Biological-Robotics-at-Tulsa/The-TU-Hand/Drawings/Fusion 360/submarine_tether_concept.PNG

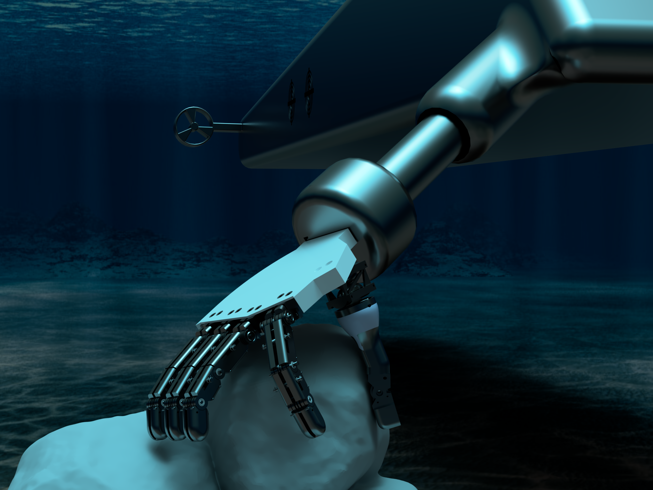
Drawings/Fusion 360/submarine_tether_concept.PNG
