Biological-Robotics-at-Tulsa/The-TU-Hand/Drawings/TU Hand 2019.JPG

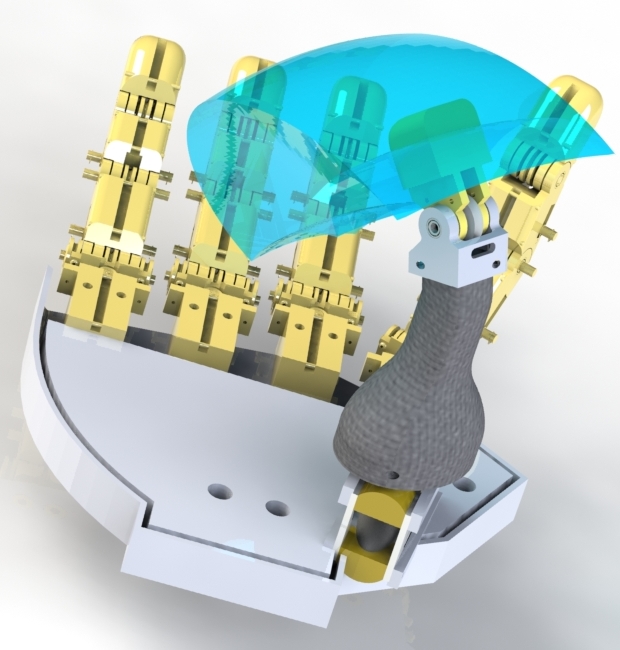
Drawings/TU Hand 2019.JPG
