Biological-Robotics-at-Tulsa/The-TU-Hand/README.md

# The-TU-Hand
A biologically inspired robotic hand for the evaluation of grasping and dexterity experiments.

## Contents
- Bill of Materials
- Drawings
- Firmware
- How-to Guides
