Biological-Robotics-at-Tulsa/The-TU-Hand/Drawings/Distal Phalanx for Pinky Finger - TU Hand 2019 v1.pdf

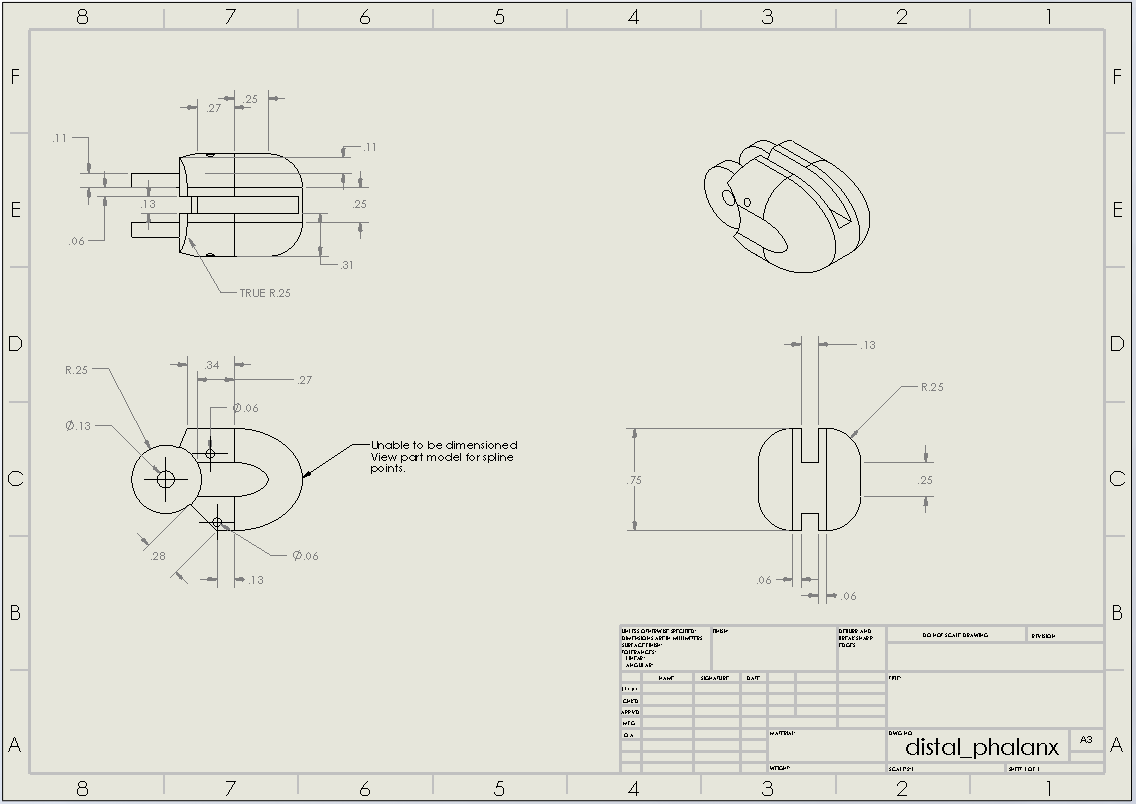
[picture p3: page 1]

All Dimensions in Inches .
