Biological-Robotics-at-Tulsa/The-TU-Hand/Drawings/NiPun - TU Hand 2019 v1.pdf

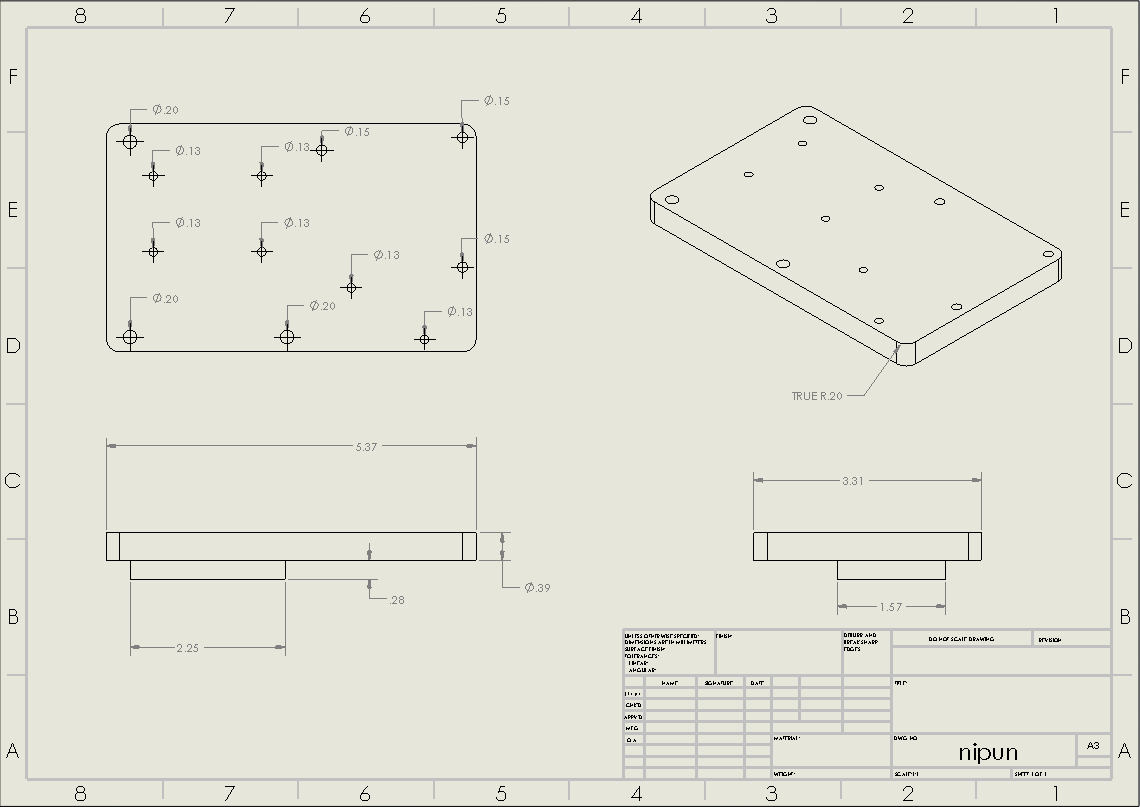
[picture p4: page 1]

All Dimensions in Inches .
