Biological-Robotics-at-Tulsa/The-TU-Hand/Drawings/TU Hand 2018.png

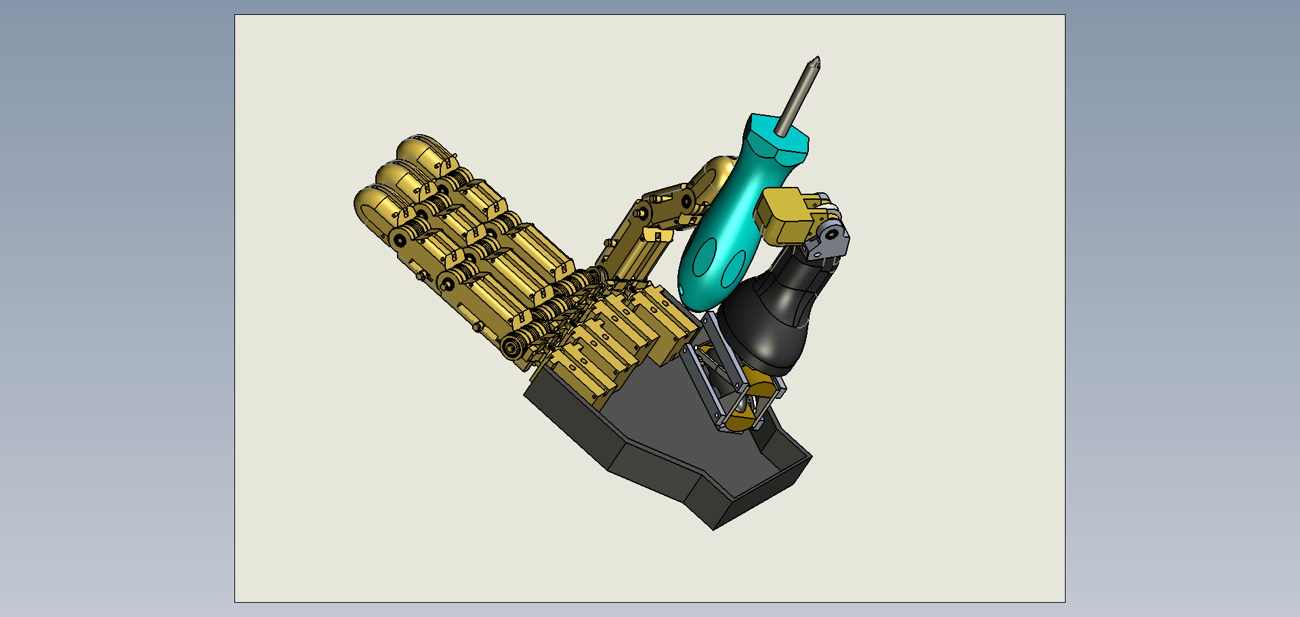
Drawings/TU Hand 2018.png
