Biological-Robotics-at-Tulsa/The-TU-Hand/Drawings/TU Hand 2018_2.png

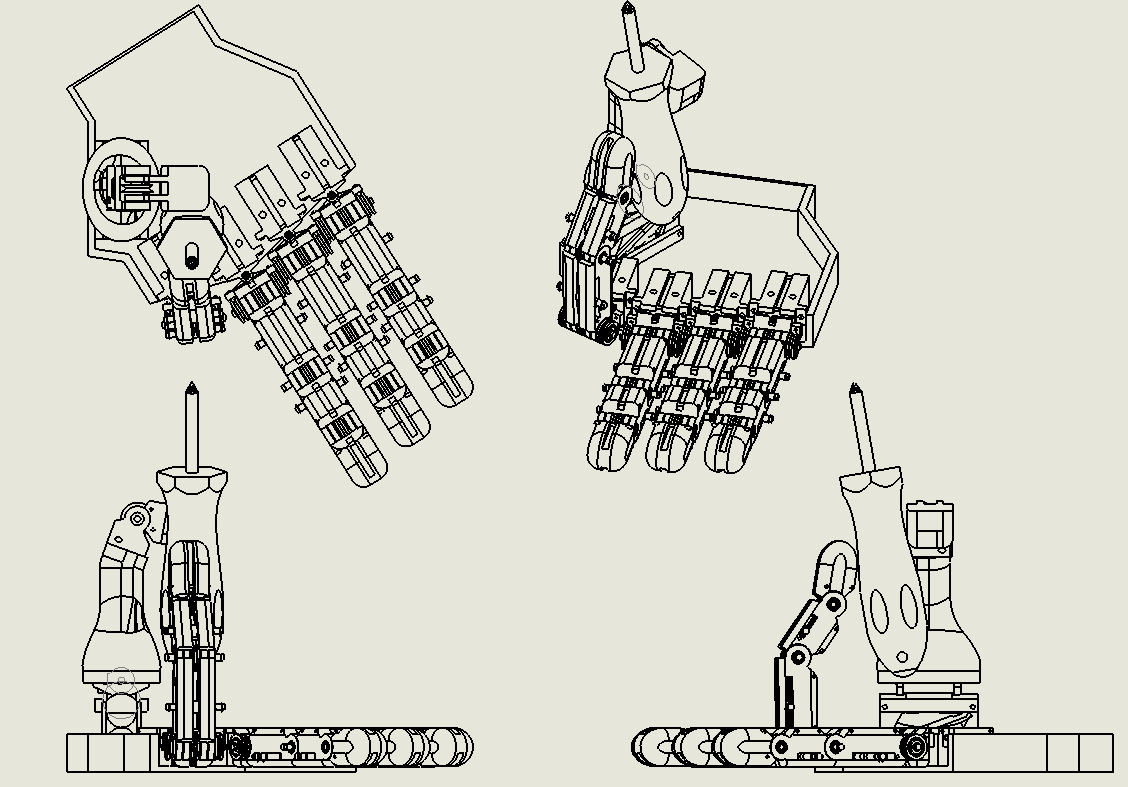
Drawings/TU Hand 2018_2.png
