Biological-Robotics-at-Tulsa/The-TU-Hand/Drawings/TU_Hand_2019_CustomizedView.png

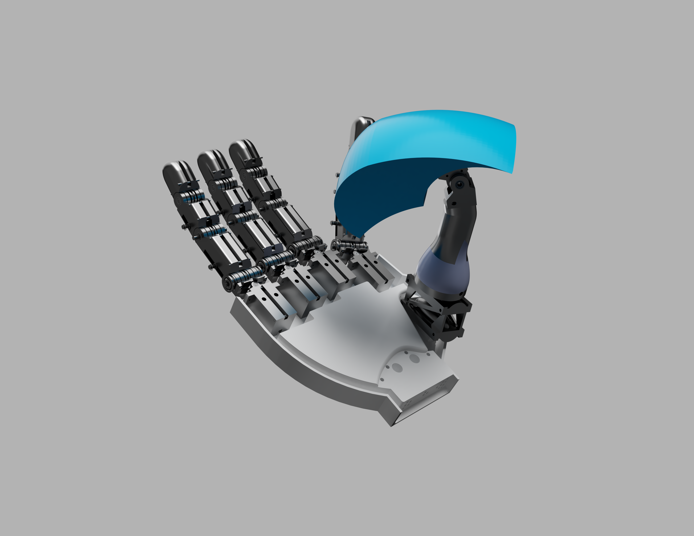
Drawings/TU_Hand_2019_CustomizedView.png
