Biological-Robotics-at-Tulsa/The-TU-Hand/Bill of Materials/TU_Hand_BOM.xlsx

TU Hand: Bill of Materials
Description | Vendor | Part Number | Link | Quantity | Unit Price | Extended Price | Percentage of Total
166 oz-in Stepper Motor | AutomationDirect | STP-MTR-23055 | http://www.automationdirect.com/adc/Shopping/Catalog/Motion_Control/Stepper_Systems/Stepper_Motors_-z-_Cables/STP-MTR-23055 | 2 | 35.50 | 71.00 | 5.14
18"x18"x1/4" Acrylic | McMaster-Carr | 8473K347 | https://www.mcmaster.com/#8473k347/=15dbq20 | 1 | 150.30 | 150.30 | 10.88
Arduino Uno - R3 | SparkFun | 11021 | https://www.sparkfun.com/products/11021 | 1 | 24.95 | 24.95 | 1.81
16mm Ball Screw 1000mm long | VXB | SFU1605-1000 | http://www.vxb.com/ProductDetails.asp?ProductCode=SFU1605-1000 | 1 | 39.77 | 39.77 | 2.88
16mm ball screw single nut | VXB | SFU1605-3 NUT | http://www.vxb.com/SFU1605-3-crew-nut-16-mm-ball-screw-single-nut-p/sfu1605-3%20nut.htm | 2 | 28.77 | 57.54 | 4.17
1/4" Flexible Shaft Coupling | McMaster-Carr | 6408K11 | http://www.mcmaster.com/#6408k11/=13xtqsv | 2 | 3.78 | 7.56 | 0.55
16mm Flexible Shaft Coupling | McMaster-Carr | 6408k11 | http://www.mcmaster.com/#6408k11/=13xtr06 | 4 | 3.78 | 15.12 | 1.09
Buna-N Spider for 1-5/64" Outside Diameter Flexible Shaft Coupling | McMaster-Carr | 6408K84 | http://www.mcmaster.com/#6408k84/=13sq7qb | 2 | 2.47 | 4.94 | 0.36
Dry-Running Mounted Sleeve Bearings for Extreme Misalignment | McMaster-Carr | 6687K17 | http://www.mcmaster.com/#6687k17/=1451aue | 2 | 9.56 | 19.12 | 1.38
Miniature Guide Rail, 9 mm Wide, for Clean-Room Threaded-Hole Carriage 280mm | McMaster-Carr | 6725K43 | http://www.mcmaster.com/#6725k43/=1451fu2 | 2 | 145.60 | 291.20 | 21.09
Miniature Ball Bearing Carriage | McMaster-Carr | 8438K3 | http://www.mcmaster.com/#8438k3/=144zxff | 2 | 75.53 | 151.06 | 10.94
Lever-Lock Hinge | McMaster-Carr | 1604A43 | http://www.mcmaster.com/#1604a43/=148momd | 1 | 16.56 | 16.56 | 1.20
Delrin Block (for ball nut mount) | McMaster-Carr | 8739K94 | https://www.mcmaster.com/#8739k94/=15dc0kx | 1 | 35.22 | 35.22 | 2.55
Molex 44914 through-hole plug | Digi-key | WM14605-ND | http://www.digikey.com/product-detail/en/molex-llc/0449140401/WM14605-ND/3311247 | 2 | 1.66 | 3.32 | 0.24
Dual H-bridge | Digi-key | 497-2936-5-ND | http://www.digikey.com/product-detail/en/stmicroelectronics/L293D/497-2936-5-ND/634700 | 2 | 3.90 | 7.80 | 0.56
DIP Socket | Digi-key | AE9992-ND | http://www.digikey.com/product-detail/en/assmann-wsw-components/A-16-LC-TT/AE9992-ND/821746 | 2 | 0.25 | 0.50 | 0.04
Hinged Limit Switch | Mouser | 653-SS-5GLT | http://www.mouser.com/ProductDetail/Omron/SS-5GLT/?qs=0w99tykdtPIhjRSArlB%2Fzw%3D%3D | 2 | 1.76 | 3.52 | 0.25
20W AC Adapter | Mouser | 709-GST25A05-P1J | http://www.mouser.com/ProductDetail/Mean-Well/GST25A05-P1J/?qs=drgMNd%252bkGPOX8brSXUPVtQ%3D%3D | 1 | 13.33 | 13.33 | 0.97
DC Barrel Jack to Terminal Block | Mouser | 992-JACK21-F-TERM | http://www.mouser.com/ProductDetail/Gravitech/JACK21-F-TERM/?qs=sGAEpiMZZMv9Q1JI0Mo%2fteGlFukZPWTG | 1 | 2.75 | 2.75 | 0.20
sleeve bearing, 1/8" shaft, 1/4" OD | McMaster-Carr | 6391K113 | http://www.mcmaster.com/#6391k113/=14roq4b | 10 | 0.68 | 6.80 | 0.49
Pulley for Wire Rope 1/2" OD | McMaster-Carr | 3434T210 | http://www.mcmaster.com/#3434t21/=13xq9m6 | 30 | 4.00 | 120.00 | 8.69
Alloy Steel Dowel Pin; Black Oxide, 1/8" Diameter, 3/4" Length | McMaster-Carr | 98381A308 | https://www.mcmaster.com/#98381a308/=15dq1ls | 1 | 6.39 | 6.39 | 0.46
Alloy Steel Dowel Pin; 1/16" Diameter, 3/4" Length | McMaster-Carr | 98381A422 | https://www.mcmaster.com/#98381a422/=15dq30i | 1 | 10.07 | 10.07 | 0.73
5/32" Stainless Steel Ball Bearing for .047" shaft | McMaster-Carr | 57155K359 | http://www.mcmaster.com/#57155k359/=13wc40e | 10 | 7.72 | 77.20 | 5.59
Alloy Steel Dowel Pin 3/64" diameter | McMaster-Carr | 98381A984 | http://www.mcmaster.com/#98381a984/=13xq7mb | 1 | 7.87 | 7.87 | 0.57
1/4" Stainless Steel Ball Bearing for 1/8" shaft | McMaster-Carr | 57155K346 | https://www.mcmaster.com/#57155k346/=15dqbci | 30 | 5.05 | 151.50 | 10.97
500M 100lbs Dyneema Braided Fishing Line | Amazon | N/A | https://www.amazon.ca/100LB-Dyneema-Strong-Braided-Fishing/dp/B009661Y72 | 0.25 | 13.61 | 3.40 | 0.25
System 1000 Epoxy Resin and 1025 Hardener | Fibre Glast | 1000/1025-A | http://www.fibreglast.com/product/System-1000-Epoxy/Epoxy_Resins | 0.25 | 52.95 | 13.24 | 0.96
1/16" Milled Glass Fibers | Fibre Glast | 29-A | http://www.fibreglast.com/product/116_inch_Milled_Glass_Fibers_29/Fillers | 0.021 | 19.95 | 0.42 | 0.03
Dry Woven Carbon Fiber 50"x36" | Rock West Comosites | 13006-D | https://www.rockwestcomposites.com/materials-tools/fabrics-pre-pregs-tow/carbon-fiber-fabric/13006-d | 1 | 55.99 | 55.99 | 4.05
Derailleur Cable Housing and Ferrules | Amazon | N/A | https://www.amazon.com/Jagwire-Lex-Derailleur-4mm-Liner/dp/B01789FVYA | 0.5 | 25.15 | 12.57 | 0.91
 |  |  |  |  | Total Cost: | 1381.01
