Biological-Robotics-at-Tulsa/The-TU-Hand/Drawings/Gazebo URDF Simulation/postfinal_TUHand/meshes/middle_mcp_flex.STL

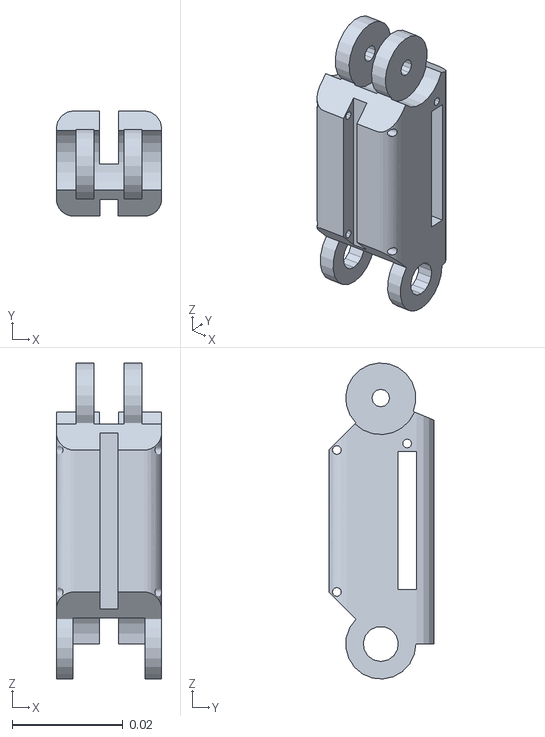
[picture p8: CAD file, 2025-08-05]
Drawings/Gazebo URDF Simulation/postfinal_TUHand/meshes/middle_mcp_flex.STL
0.0191 x 0.0191 x 0.0571
