Biological-Robotics-at-Tulsa/The-TU-Hand/Drawings/Robotic Operating System (ROS)/URDF/TUHand_6.0_URDF/m_trans_link.STL

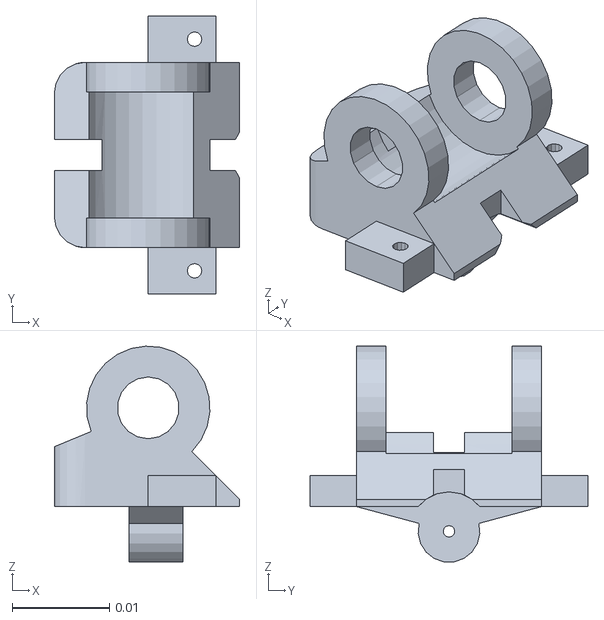
[picture p9: CAD file, 2025-08-05]
Drawings/Robotic Operating System (ROS)/URDF/TUHand_6.0_URDF/m_trans_link.STL
0.0191 x 0.0286 x 0.0222
