Biological-Robotics-at-Tulsa/The-TU-Hand/Drawings/Solidworks/TU Hand 2018_2.DXF

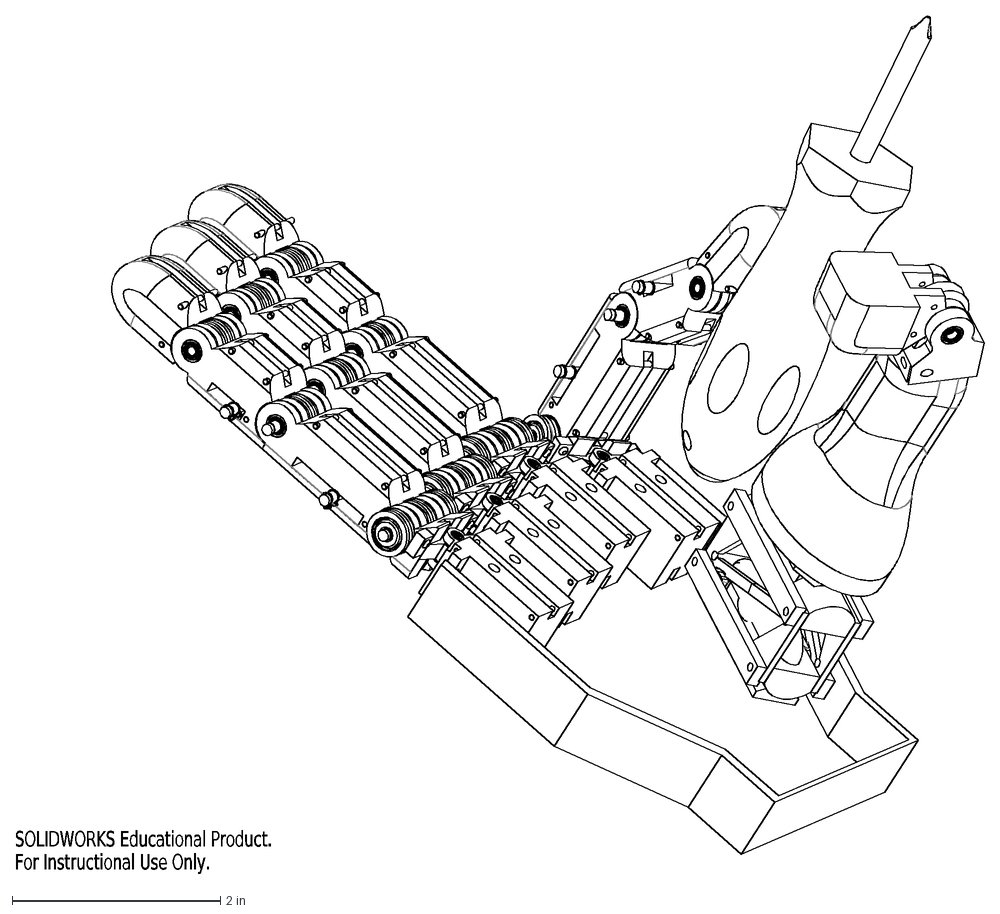
[picture p10: CAD file, 2019-10-30]
Drawings/Solidworks/TU Hand 2018_2.DXF
SOLIDWORKS Educational Product.
For Instructional Use Only.
