Biological-Robotics-at-Tulsa/The-TU-Hand/Drawings/Solidworks/TU Hand 2019/CopyDesignTemp/URDF_57155K359_SS BALL BEARING.SLDPRT

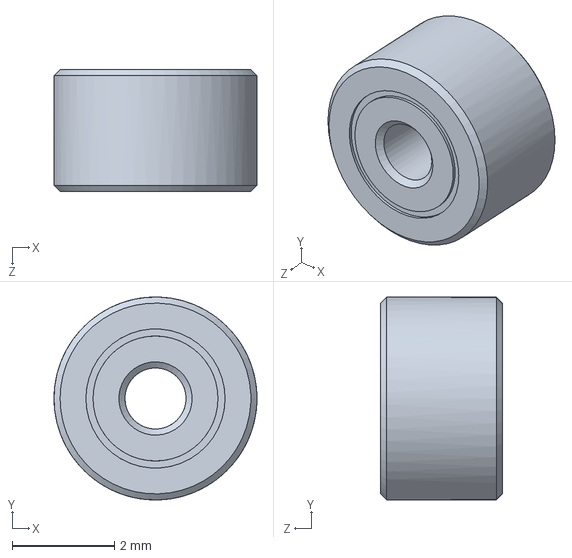
[picture p11: CAD file, 2019-10-30]
Drawings/Solidworks/TU Hand 2019/CopyDesignTemp/URDF_57155K359_SS BALL BEARING.SLDPRT
3.97 x 3.97 x 2.38 mm
