Biological-Robotics-at-Tulsa/The-TU-Hand/Drawings/Solidworks/TU Hand 2019/rattlesnake_bonding_surface.SLDPRT

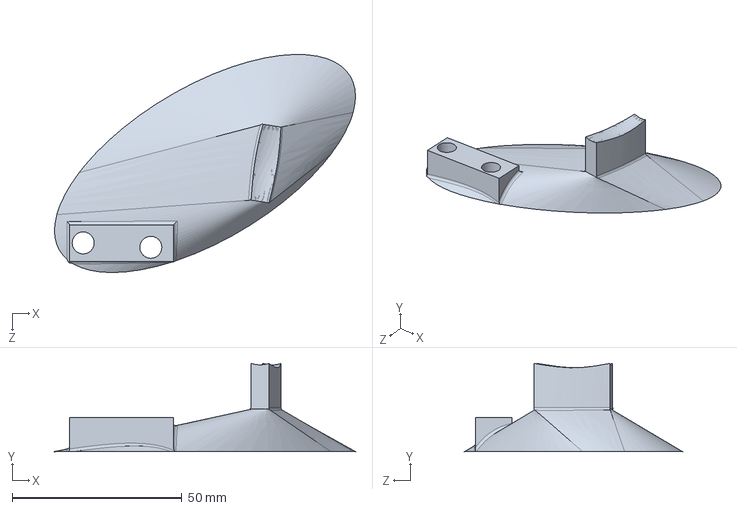
[picture p12: CAD file, 2019-10-30]
Drawings/Solidworks/TU Hand 2019/rattlesnake_bonding_surface.SLDPRT
88.8 x 26.0 x 64.3 mm
