Biological-Robotics-at-Tulsa/The-TU-Hand/Drawings/Gazebo URDF Simulation/postfinal_TUHand/meshes/ring_dp_flex.STL

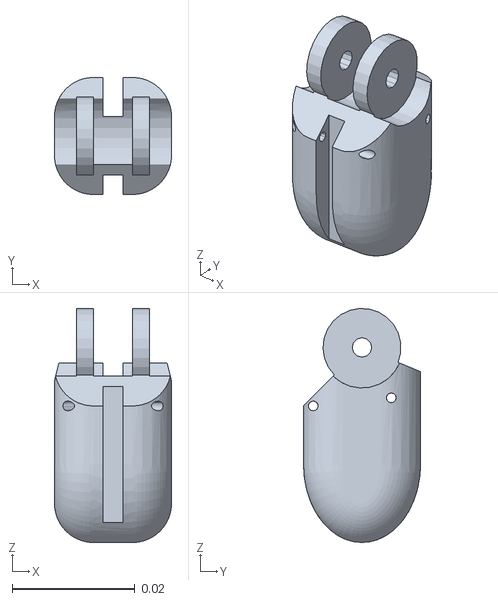
[picture p13: CAD file, 2025-08-05]
Drawings/Gazebo URDF Simulation/postfinal_TUHand/meshes/ring_dp_flex.STL
0.0191 x 0.0191 x 0.0381
