Biological-Robotics-at-Tulsa/The-TU-Hand/Drawings/Robotic Operating System (ROS)/URDF/TUHand_6.0_URDF/p_middle_link.STL

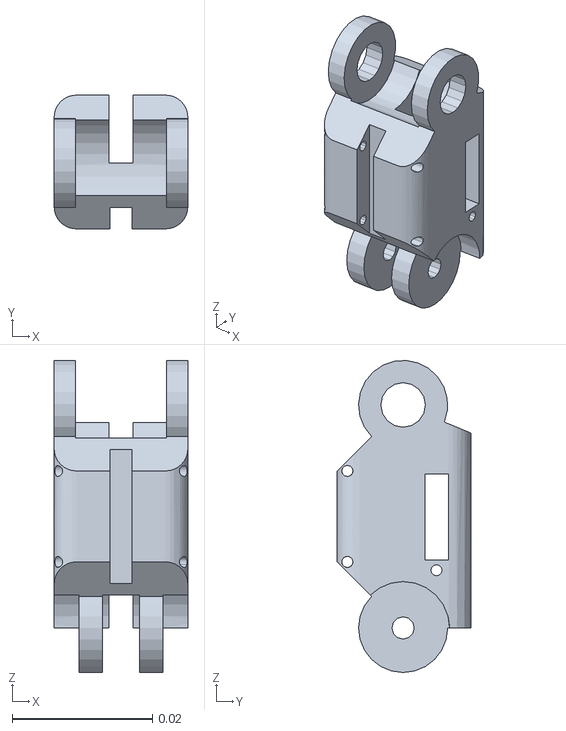
[picture p14: CAD file, 2025-08-05]
Drawings/Robotic Operating System (ROS)/URDF/TUHand_6.0_URDF/p_middle_link.STL
0.0191 x 0.0191 x 0.0444
