Biological-Robotics-at-Tulsa/The-TU-Hand/Drawings/Solidworks/TU Hand 2018.DXF

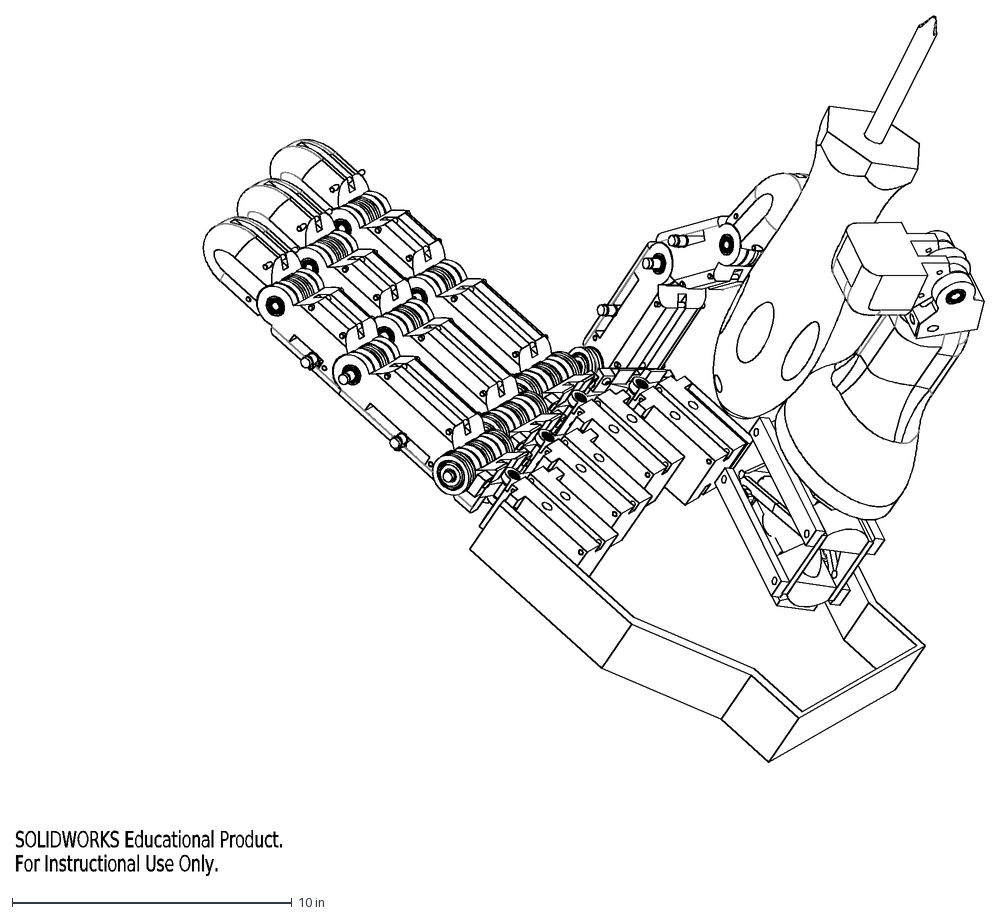
[picture p15: CAD file, 2019-10-30]
Drawings/Solidworks/TU Hand 2018.DXF
SOLIDWORKS Educational Product.
For Instructional Use Only.
