Biological-Robotics-at-Tulsa/The-TU-Hand/Drawings/Solidworks/TU Hand 2019/CopyDesignTemp/URDF_97633A110_BLACK-FINISH STEEL EXTERNAL RETAINING RING.SLDPRT

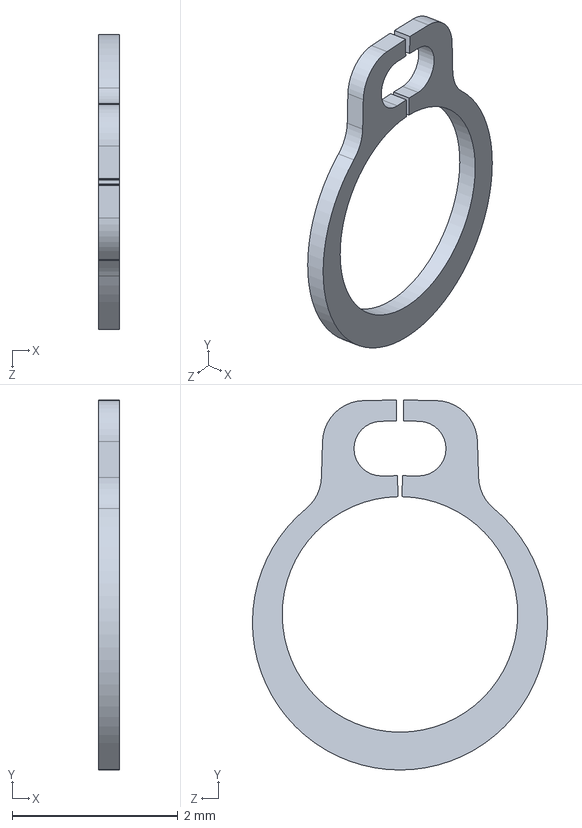
[picture p16: CAD file, 2019-10-30]
Drawings/Solidworks/TU Hand 2019/CopyDesignTemp/URDF_97633A110_BLACK-FINISH STEEL EXTERNAL RETAINING RING.SLDPRT
0.254 x 4.47 x 3.57 mm
