Biological-Robotics-at-Tulsa/The-TU-Hand/Drawings/Solidworks/TU Hand 2019/newpalmfinal.SLDPRT

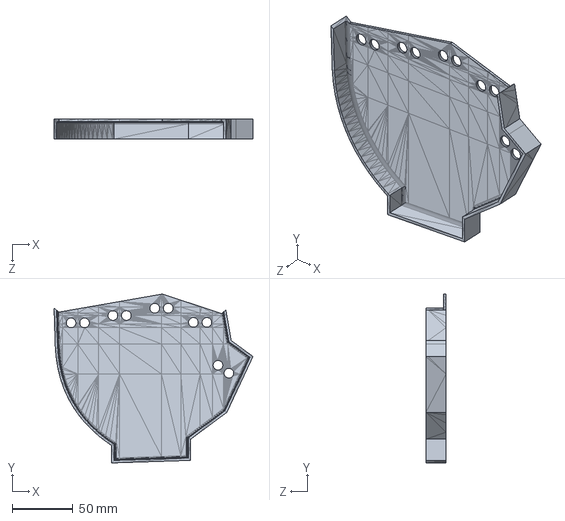
[picture p17: CAD file, 2019-10-30]
Drawings/Solidworks/TU Hand 2019/newpalmfinal.SLDPRT
164.0 x 139.2 x 16.6 mm
