Biological-Robotics-at-Tulsa/The-TU-Hand/Drawings/Gazebo URDF Simulation/postfinal_TUHand/meshes/thumb_fusion.STL

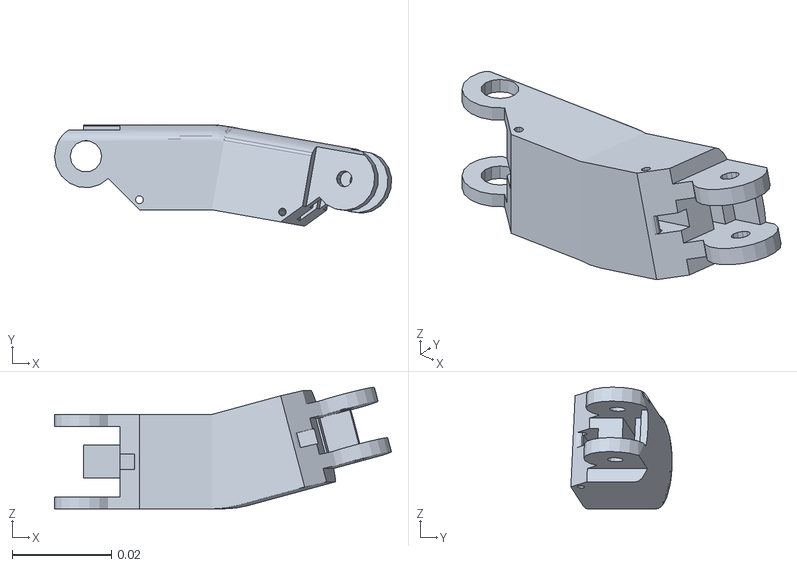
[picture p18: CAD file, 2025-08-05]
Drawings/Gazebo URDF Simulation/postfinal_TUHand/meshes/thumb_fusion.STL
0.068 x 0.0205 x 0.0246
