Biological-Robotics-at-Tulsa/The-TU-Hand/Drawings/Solidworks/TU Hand 2019/CopyDesignTemp/URDF_98381A422_ALLOY STEEL DOWEL PIN.SLDPRT

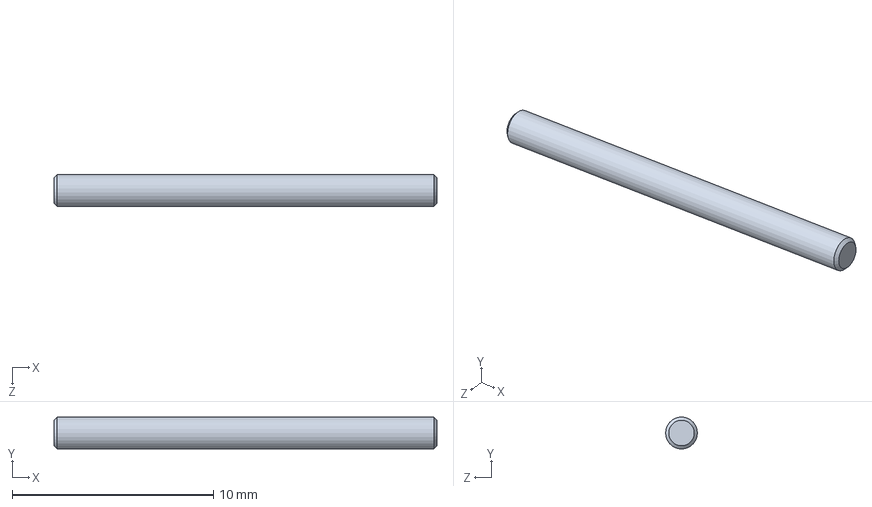
[picture p19: CAD file, 2019-10-30]
Drawings/Solidworks/TU Hand 2019/CopyDesignTemp/URDF_98381A422_ALLOY STEEL DOWEL PIN.SLDPRT
19.1 x 1.58 x 1.59 mm
