Biological-Robotics-at-Tulsa/The-TU-Hand/Drawings/Solidworks/TU Hand 2019/CopyDesignTemp/URDF_distal_phalanx.SLDPRT

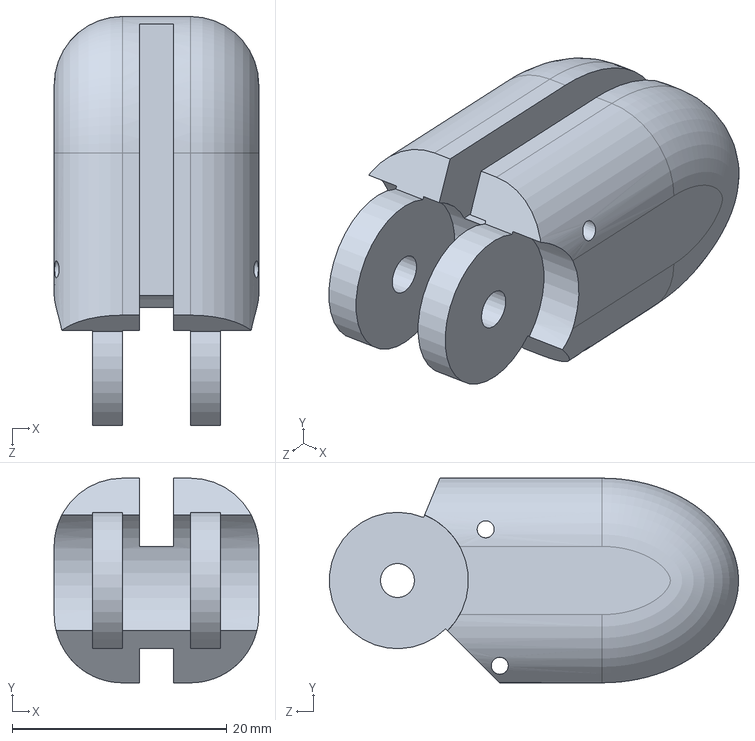
[picture p20: CAD file, 2019-10-30]
Drawings/Solidworks/TU Hand 2019/CopyDesignTemp/URDF_distal_phalanx.SLDPRT
19.1 x 19.1 x 38.1 mm
