Biological-Robotics-at-Tulsa/The-TU-Hand/Drawings/Solidworks/TU Hand 2019/CopyDesignTemp/URDF_98381A473_ALLOY STEEL DOWEL PIN.SLDPRT

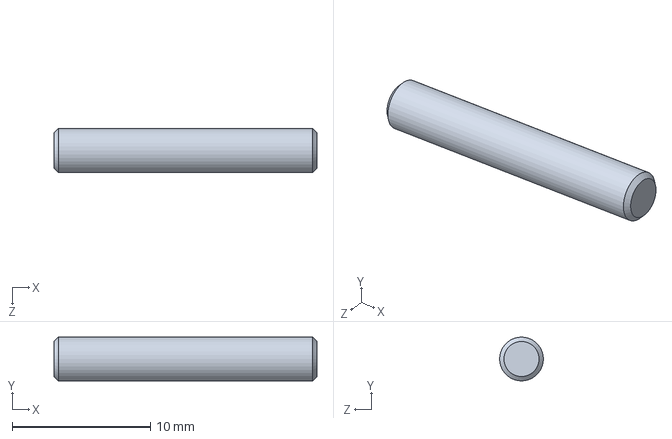
[picture p21: CAD file, 2019-10-30]
Drawings/Solidworks/TU Hand 2019/CopyDesignTemp/URDF_98381A473_ALLOY STEEL DOWEL PIN.SLDPRT
19.1 x 3.17 x 3.17 mm
