Biological-Robotics-at-Tulsa/The-TU-Hand/Drawings/Solidworks/TU Hand 2019/CopyDesignTemp/URDF_proximal_phalanx.SLDPRT

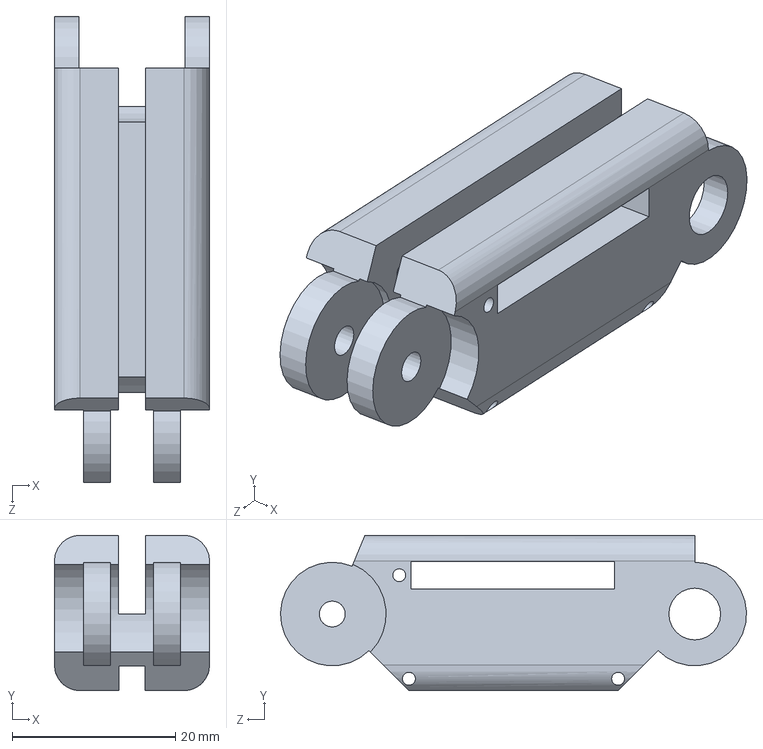
[picture p23: CAD file, 2019-10-30]
Drawings/Solidworks/TU Hand 2019/CopyDesignTemp/URDF_proximal_phalanx.SLDPRT
19.1 x 19.1 x 57.1 mm
