Biological-Robotics-at-Tulsa/The-TU-Hand/Drawings/Gazebo URDF Simulation/postfinal_TUHand/meshes/base_link.STL

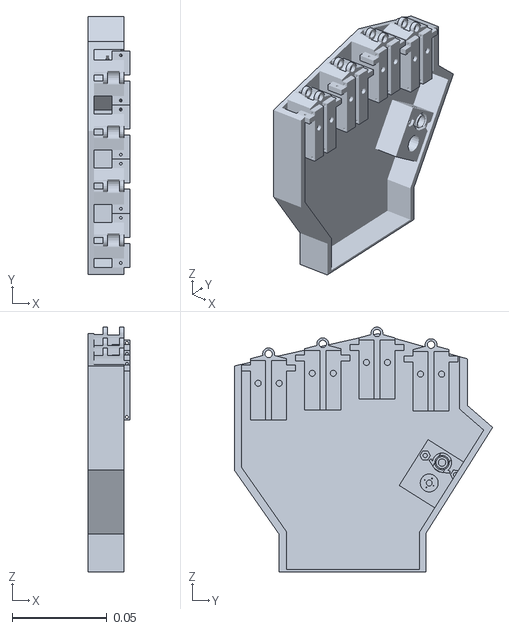
[picture p24: CAD file, 2025-08-05]
Drawings/Gazebo URDF Simulation/postfinal_TUHand/meshes/base_link.STL
0.022 x 0.136 x 0.129
