Biological-Robotics-at-Tulsa/The-TU-Hand/Drawings/Solidworks/TU Hand 2019/CopyDesignTemp/2016thumb_workspace.SLDPRT

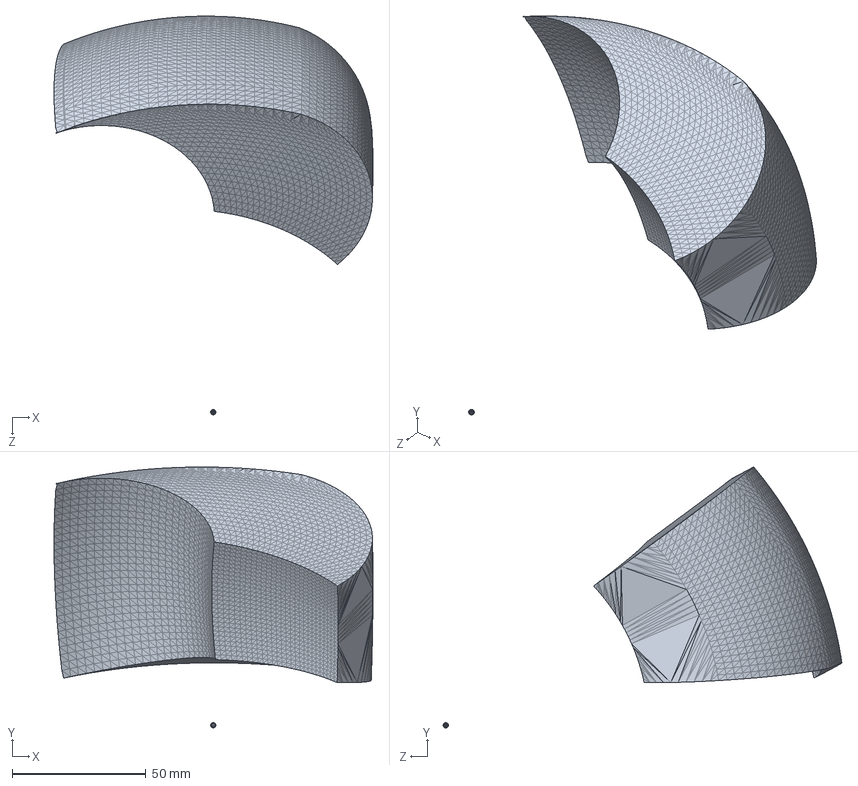
[picture p25: CAD file, 2019-10-30]
Drawings/Solidworks/TU Hand 2019/CopyDesignTemp/2016thumb_workspace.SLDPRT
119.1 x 97.4 x 148.9 mm
