Biological-Robotics-at-Tulsa/The-TU-Hand/Drawings/Solidworks/TU Hand 2019/CopyDesignTemp/URDF_metacarpal_proximal.SLDPRT

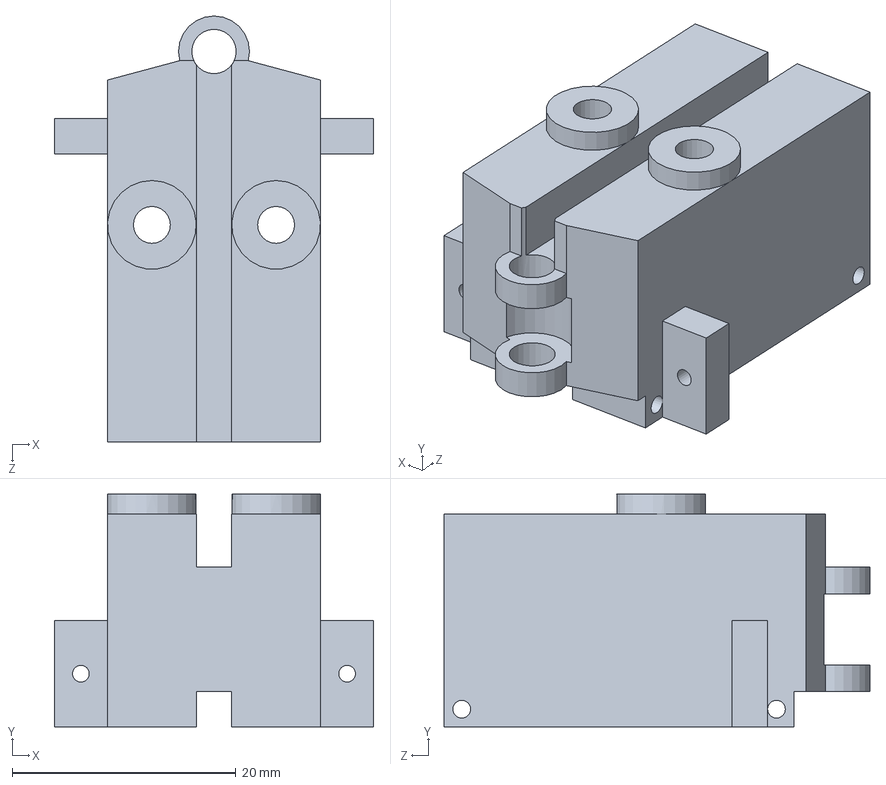
[picture p26: CAD file, 2019-10-30]
Drawings/Solidworks/TU Hand 2019/CopyDesignTemp/URDF_metacarpal_proximal.SLDPRT
28.6 x 20.8 x 38.1 mm
