Biological-Robotics-at-Tulsa/The-TU-Hand/Drawings/Solidworks/TU Hand 2019/CopyDesignTemp/URDF_3434T210_PULLEY FOR WIRE ROPE.SLDPRT

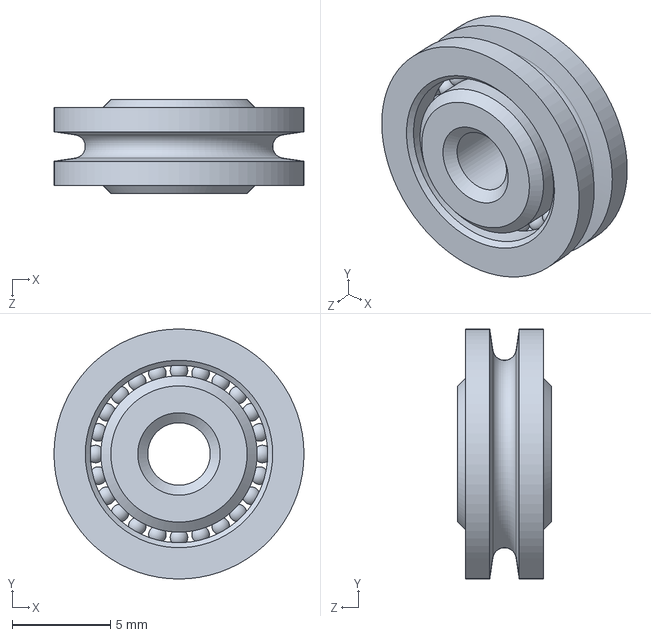
[picture p27: CAD file, 2019-10-30]
Drawings/Solidworks/TU Hand 2019/CopyDesignTemp/URDF_3434T210_PULLEY FOR WIRE ROPE.SLDPRT
12.7 x 12.7 x 4.76 mm
