Biological-Robotics-at-Tulsa/The-TU-Hand/Drawings/Gazebo URDF Simulation/postfinal_TUHand/meshes/thumb_mcp.STL

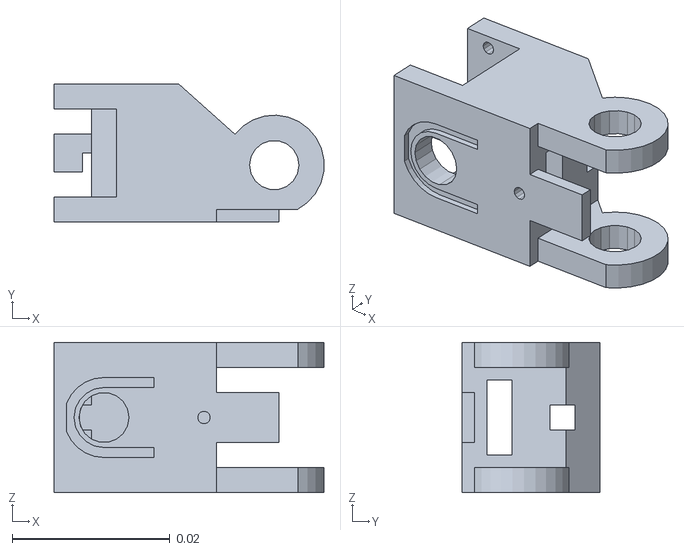
[picture p28: CAD file, 2025-08-05]
Drawings/Gazebo URDF Simulation/postfinal_TUHand/meshes/thumb_mcp.STL
0.0343 x 0.0175 x 0.0191
