Biological-Robotics-at-Tulsa/The-TU-Hand/Drawings/Solidworks/TU Hand 2019/CopyDesignTemp/rattlesnake_bonding_surface4.SLDPRT

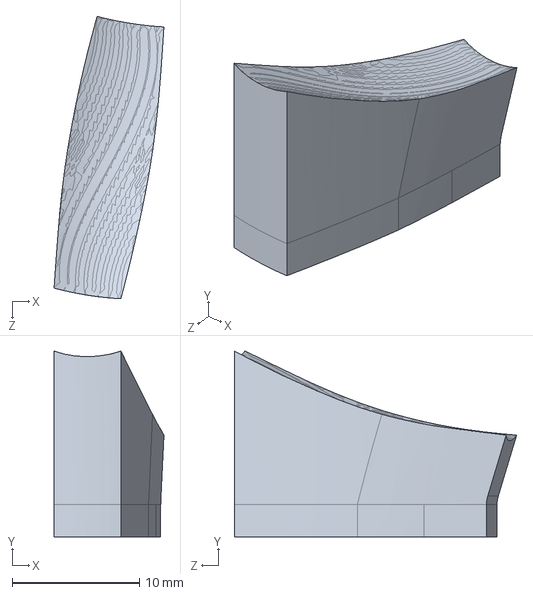
[picture p29: CAD file, 2019-10-30]
Drawings/Solidworks/TU Hand 2019/CopyDesignTemp/rattlesnake_bonding_surface4.SLDPRT
8.65 x 14.6 x 22.2 mm
