Biological-Robotics-at-Tulsa/The-TU-Hand/Drawings/Robotic Operating System (ROS)/URDF/TUHand_6.0_URDF/t_fuse_link.STL

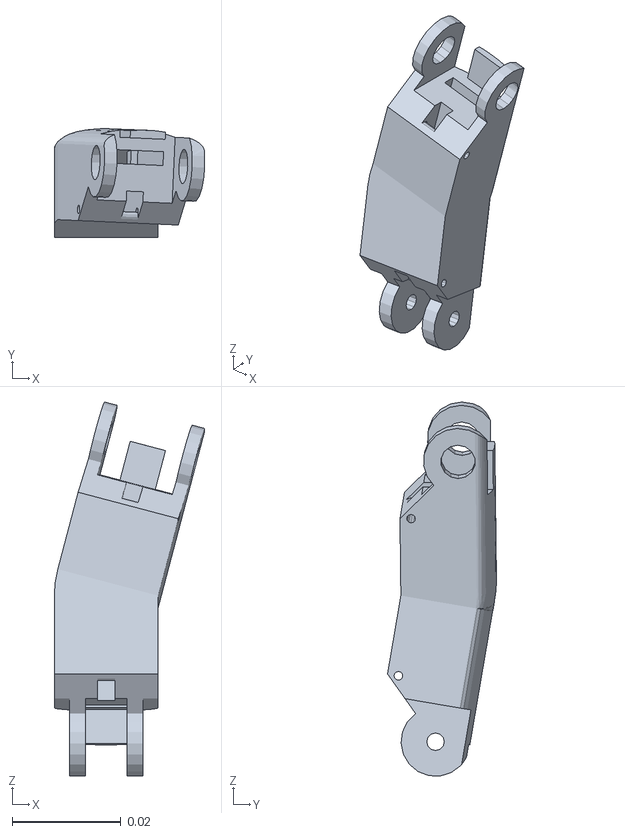
[picture p30: CAD file, 2025-08-05]
Drawings/Robotic Operating System (ROS)/URDF/TUHand_6.0_URDF/t_fuse_link.STL
0.0276 x 0.02 x 0.0687
