Biological-Robotics-at-Tulsa/The-TU-Hand/Drawings/Solidworks/TU Hand 2019/CopyDesignTemp/URDF_90145A480_long_pin_(unhardened)_SLIDER.SLDPRT

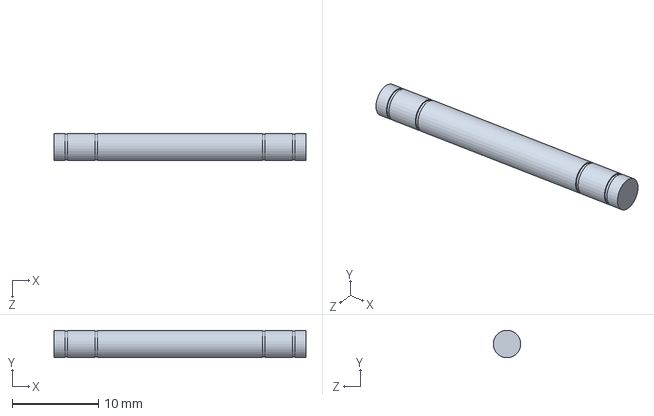
[picture p31: CAD file, 2019-10-30]
Drawings/Solidworks/TU Hand 2019/CopyDesignTemp/URDF_90145A480_long_pin_(unhardened)_SLIDER.SLDPRT
29.2 x 3.16 x 3.17 mm
