Biological-Robotics-at-Tulsa/The-TU-Hand/Drawings/Solidworks/TU Hand 2019/CopyDesignTemp/URDF_metacarpal_distal.SLDPRT

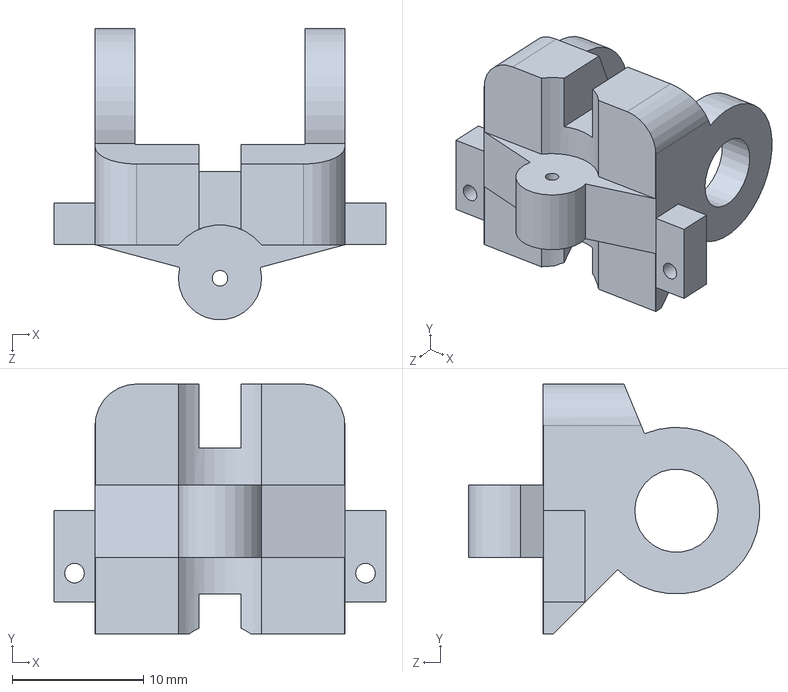
[picture p32: CAD file, 2019-10-30]
Drawings/Solidworks/TU Hand 2019/CopyDesignTemp/URDF_metacarpal_distal.SLDPRT
25.3 x 19.1 x 22.2 mm
