Biological-Robotics-at-Tulsa/The-TU-Hand/Drawings/Solidworks/TU Hand 2019/CopyDesignTemp/URDF_98381A983_pin_SHORT.SLDPRT

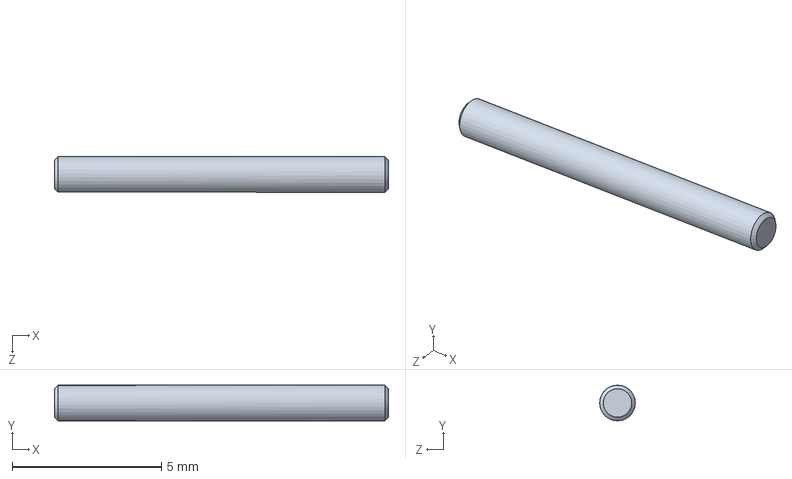
[picture p33: CAD file, 2019-10-30]
Drawings/Solidworks/TU Hand 2019/CopyDesignTemp/URDF_98381A983_pin_SHORT.SLDPRT
11.2 x 1.19 x 1.19 mm
