Biological-Robotics-at-Tulsa/The-TU-Hand/Drawings/Solidworks/TU Hand 2019/CopyDesignTemp/gear box replacement and ceramic upper mount_rot30neg.SLDPRT

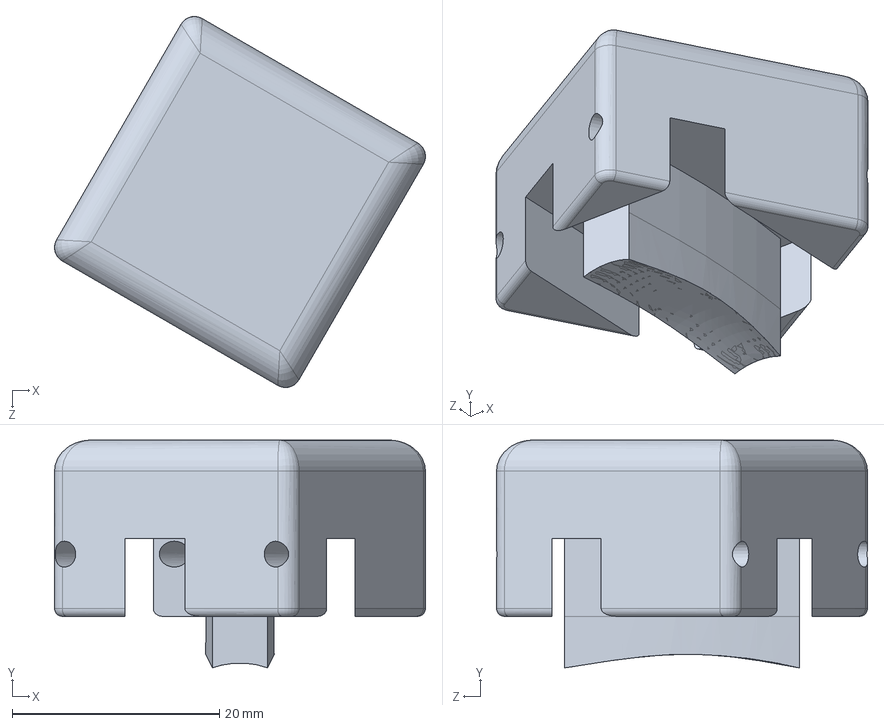
[picture p35: CAD file, 2019-10-30]
Drawings/Solidworks/TU Hand 2019/CopyDesignTemp/gear box replacement and ceramic upper mount_rot30neg.SLDPRT
35.8 x 22.0 x 35.8 mm
