Biological-Robotics-at-Tulsa/The-TU-Hand/Drawings/Solidworks/TU Hand 2019/CopyDesignTemp/URDF_6391K113_OIL-EMBEDDED SLEEVE BRNG.SLDPRT

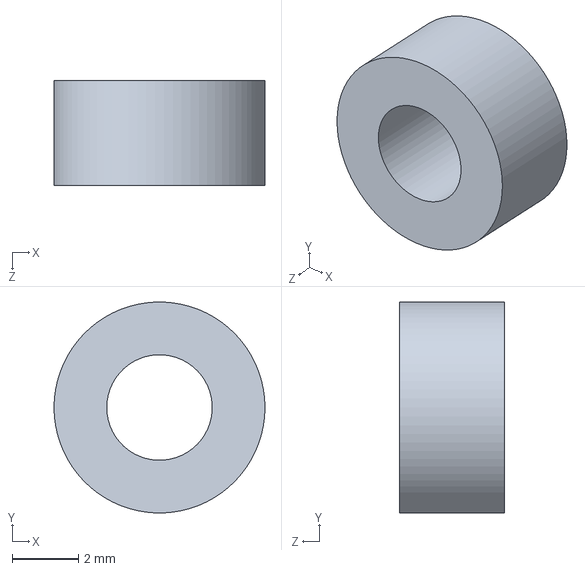
[picture p36: CAD file, 2019-10-30]
Drawings/Solidworks/TU Hand 2019/CopyDesignTemp/URDF_6391K113_OIL-EMBEDDED SLEEVE BRNG.SLDPRT
6.35 x 6.34 x 3.17 mm
