Biological-Robotics-at-Tulsa/The-TU-Hand/Drawings/Solidworks/TU Hand 2019/CopyDesignTemp/URDF_GS_2-4_Brass.SLDPRT

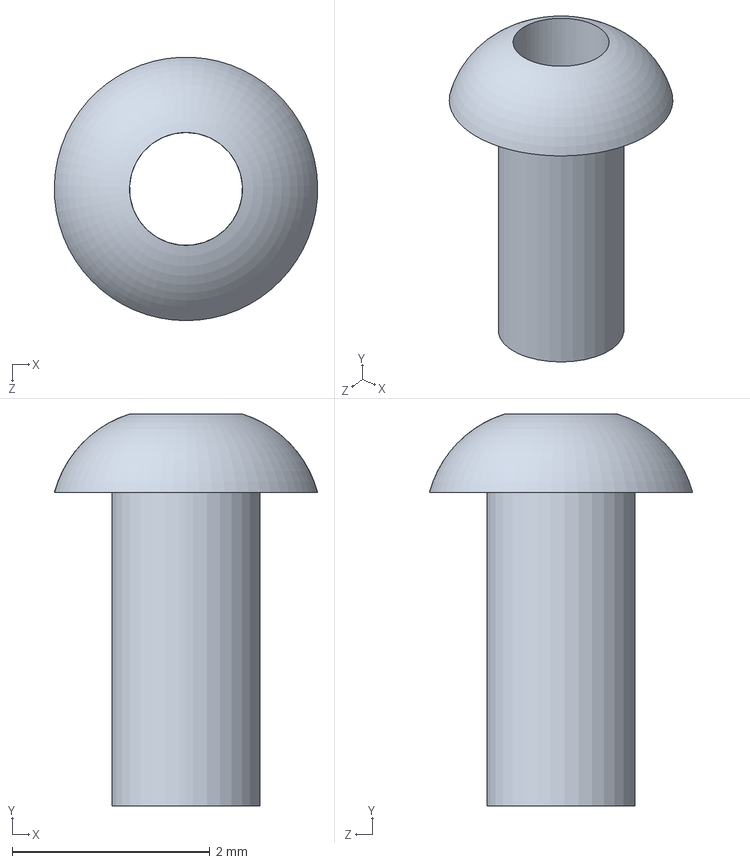
[picture p37: CAD file, 2019-10-30]
Drawings/Solidworks/TU Hand 2019/CopyDesignTemp/URDF_GS_2-4_Brass.SLDPRT
2.67 x 3.97 x 2.67 mm
