Biological-Robotics-at-Tulsa/The-TU-Hand/Drawings/Solidworks/TU Hand 2019/CopyDesignTemp/URDF_90145A480_long_pin_(unhardened)_PULLEYHOLDER.SLDPRT

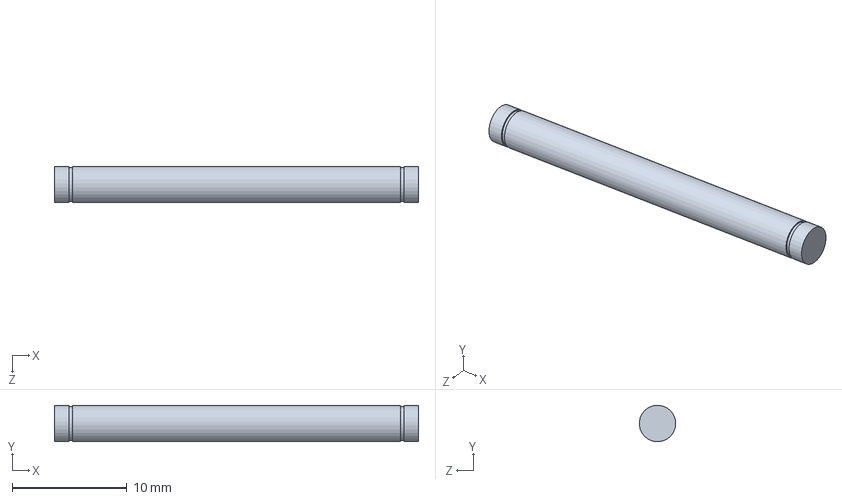
[picture p38: CAD file, 2019-10-30]
Drawings/Solidworks/TU Hand 2019/CopyDesignTemp/URDF_90145A480_long_pin_(unhardened)_PULLEYHOLDER.SLDPRT
31.7 x 3.17 x 3.17 mm
