Biological-Robotics-at-Tulsa/The-TU-Hand/(list of files, cad)

Other CAD files:
Drawings/Solidworks/TU Hand 2019/Tendon Subway System.SLDPRT
Drawings/Gazebo URDF Simulation/postfinal_TUHand/meshes/ring_mcp_rot.STL
Drawings/Gazebo URDF Simulation/postfinal_TUHand/meshes/index_mcp_rot.STL
Drawings/Robotic Operating System (ROS)/URDF/TUHand_6.0_URDF/m_proximal_link.STL
Drawings/Gazebo URDF Simulation/postfinal_TUHand/meshes/pinky_pp_flex.STL
Drawings/Robotic Operating System (ROS)/URDF/TUHand_6.0_URDF/m_dp_link.STL
Drawings/Gazebo URDF Simulation/postfinal_TUHand/meshes/index_pp_flex.STL
Drawings/Robotic Operating System (ROS)/URDF/TUHand_6.0_URDF/r_proximal_link.STL
Drawings/Gazebo URDF Simulation/postfinal_TUHand/meshes/pinky_mcp_rot2.STL
Drawings/Robotic Operating System (ROS)/URDF/TUHand_6.0_URDF/i_dp_link.STL
Drawings/Gazebo URDF Simulation/postfinal_TUHand/meshes/middle_mcp_rot.STL
Drawings/Robotic Operating System (ROS)/URDF/TUHand_6.0_URDF/p_dp_link.STL
Drawings/Robotic Operating System (ROS)/URDF/TUHand_6.0_URDF/r_dp_link.STL
Drawings/Gazebo URDF Simulation/postfinal_TUHand/meshes/middle_pp_flex.STL
Drawings/Robotic Operating System (ROS)/URDF/TUHand_6.0_URDF/palm.STL
Drawings/Gazebo URDF Simulation/postfinal_TUHand/meshes/ring_pp_flex.STL
Drawings/Robotic Operating System (ROS)/URDF/TUHand_6.0_URDF/t_top_link.STL
Drawings/Gazebo URDF Simulation/postfinal_TUHand/meshes/thumb_dp.STL
Drawings/Robotic Operating System (ROS)/URDF/TUHand_6.0_URDF/i_proximal_link.STL
Drawings/Robotic Operating System (ROS)/URDF/dev_archive/TU_Hand_URDF/meshes/i_dp_link.STL
Drawings/Robotic Operating System (ROS)/URDF/dev_archive/TU_Hand_URDF/meshes/i_proximal_link.STL
Drawings/Robotic Operating System (ROS)/URDF/dev_archive/TU_Hand_URDF/meshes/m_dp_link.STL
Drawings/Robotic Operating System (ROS)/URDF/dev_archive/TU_Hand_URDF/meshes/m_proximal_link.STL
Drawings/Robotic Operating System (ROS)/URDF/dev_archive/TU_Hand_URDF/meshes/p_dp_link.STL
Drawings/Robotic Operating System (ROS)/URDF/dev_archive/TU_Hand_URDF/meshes/palm.STL
Drawings/Robotic Operating System (ROS)/URDF/dev_archive/TU_Hand_URDF/meshes/r_dp_link.STL
Drawings/Robotic Operating System (ROS)/URDF/dev_archive/TU_Hand_URDF/meshes/r_proximal_link.STL
Drawings/Robotic Operating System (ROS)/URDF/dev_archive/TU_Hand_URDF/meshes/t_top_link.STL
Drawings/Robotic Operating System (ROS)/URDF/dev_archive/postfinal_TUHand/meshes/index_mcp_rot.STL
Drawings/Robotic Operating System (ROS)/URDF/dev_archive/postfinal_TUHand/meshes/index_pp_flex.STL
Drawings/Robotic Operating System (ROS)/URDF/dev_archive/postfinal_TUHand/meshes/middle_mcp_rot.STL
Drawings/Robotic Operating System (ROS)/URDF/dev_archive/postfinal_TUHand/meshes/middle_pp_flex.STL
Drawings/Robotic Operating System (ROS)/URDF/dev_archive/postfinal_TUHand/meshes/pinky_mcp_rot2.STL
Drawings/Robotic Operating System (ROS)/URDF/dev_archive/postfinal_TUHand/meshes/pinky_pp_flex.STL
Drawings/Robotic Operating System (ROS)/URDF/dev_archive/postfinal_TUHand/meshes/ring_mcp_rot.STL
Drawings/Robotic Operating System (ROS)/URDF/dev_archive/postfinal_TUHand/meshes/ring_pp_flex.STL
Drawings/Robotic Operating System (ROS)/URDF/dev_archive/postfinal_TUHand/meshes/thumb_dp.STL
Drawings/Solidworks/TU Hand 2019/CopyDesignTemp/57155K346_SS BALL BEARING.SLDPRT
Drawings/slddrw files/distal_phalanx.SLDDRW
Drawings/slddrw files/metacarpal_distal.SLDDRW
Drawings/slddrw files/metacarpal_proximal.SLDDRW
Drawings/slddrw files/middle_phalanx.SLDDRW
Drawings/slddrw files/nipun.SLDDRW
Drawings/slddrw files/proximal_phalanx.SLDDRW
