Biological-Robotics-at-Tulsa/The-TU-Hand/Drawings/Robotic Operating System (ROS)/URDF/exampleview.png

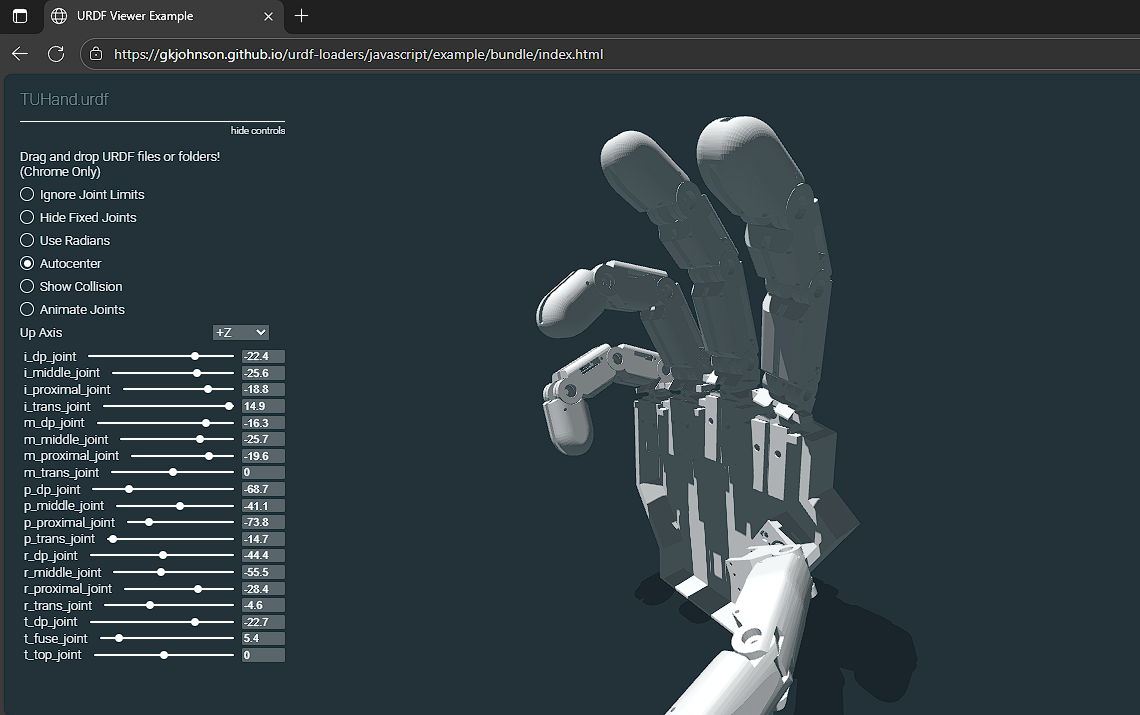
Drawings/Robotic Operating System (ROS)/URDF/exampleview.png
