Biological-Robotics-at-Tulsa/The-TU-Hand/Drawings/Robotic Operating System (ROS)/URDF/IMG_2358.GIF

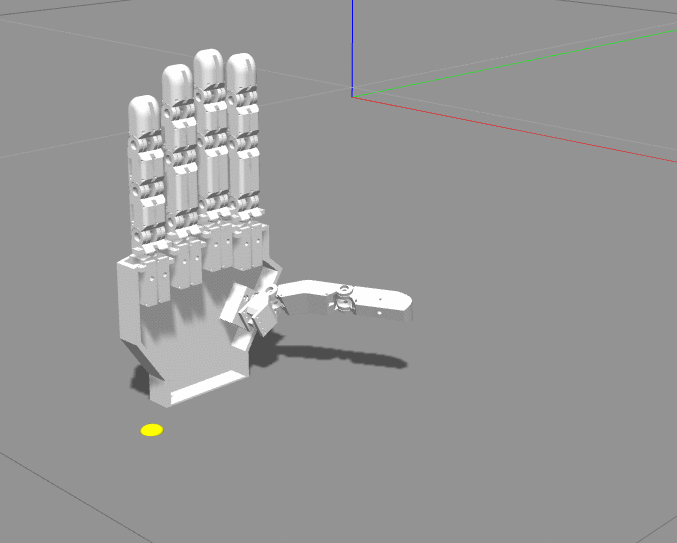
Drawings/Robotic Operating System (ROS)/URDF/IMG_2358.GIF
