Biological-Robotics-at-Tulsa/The-TU-Hand/Firmware/Mobile Robotic Hand Testbed/README.md

#TU Hand Control
Firmware for the Tiva C microcontroller for the TU Hand, developed as a joint project between Mechanical and Electrical Engineering Undergraduates in 2017. 

Hosted at:

https://github.com/wesleysliao/TUhandControl
