Biological-Robotics-at-Tulsa/The-TU-Hand/Drawings/Distal Phalanx for Index Middle Ring Fingers - TU Hand 2019 v1.pdf

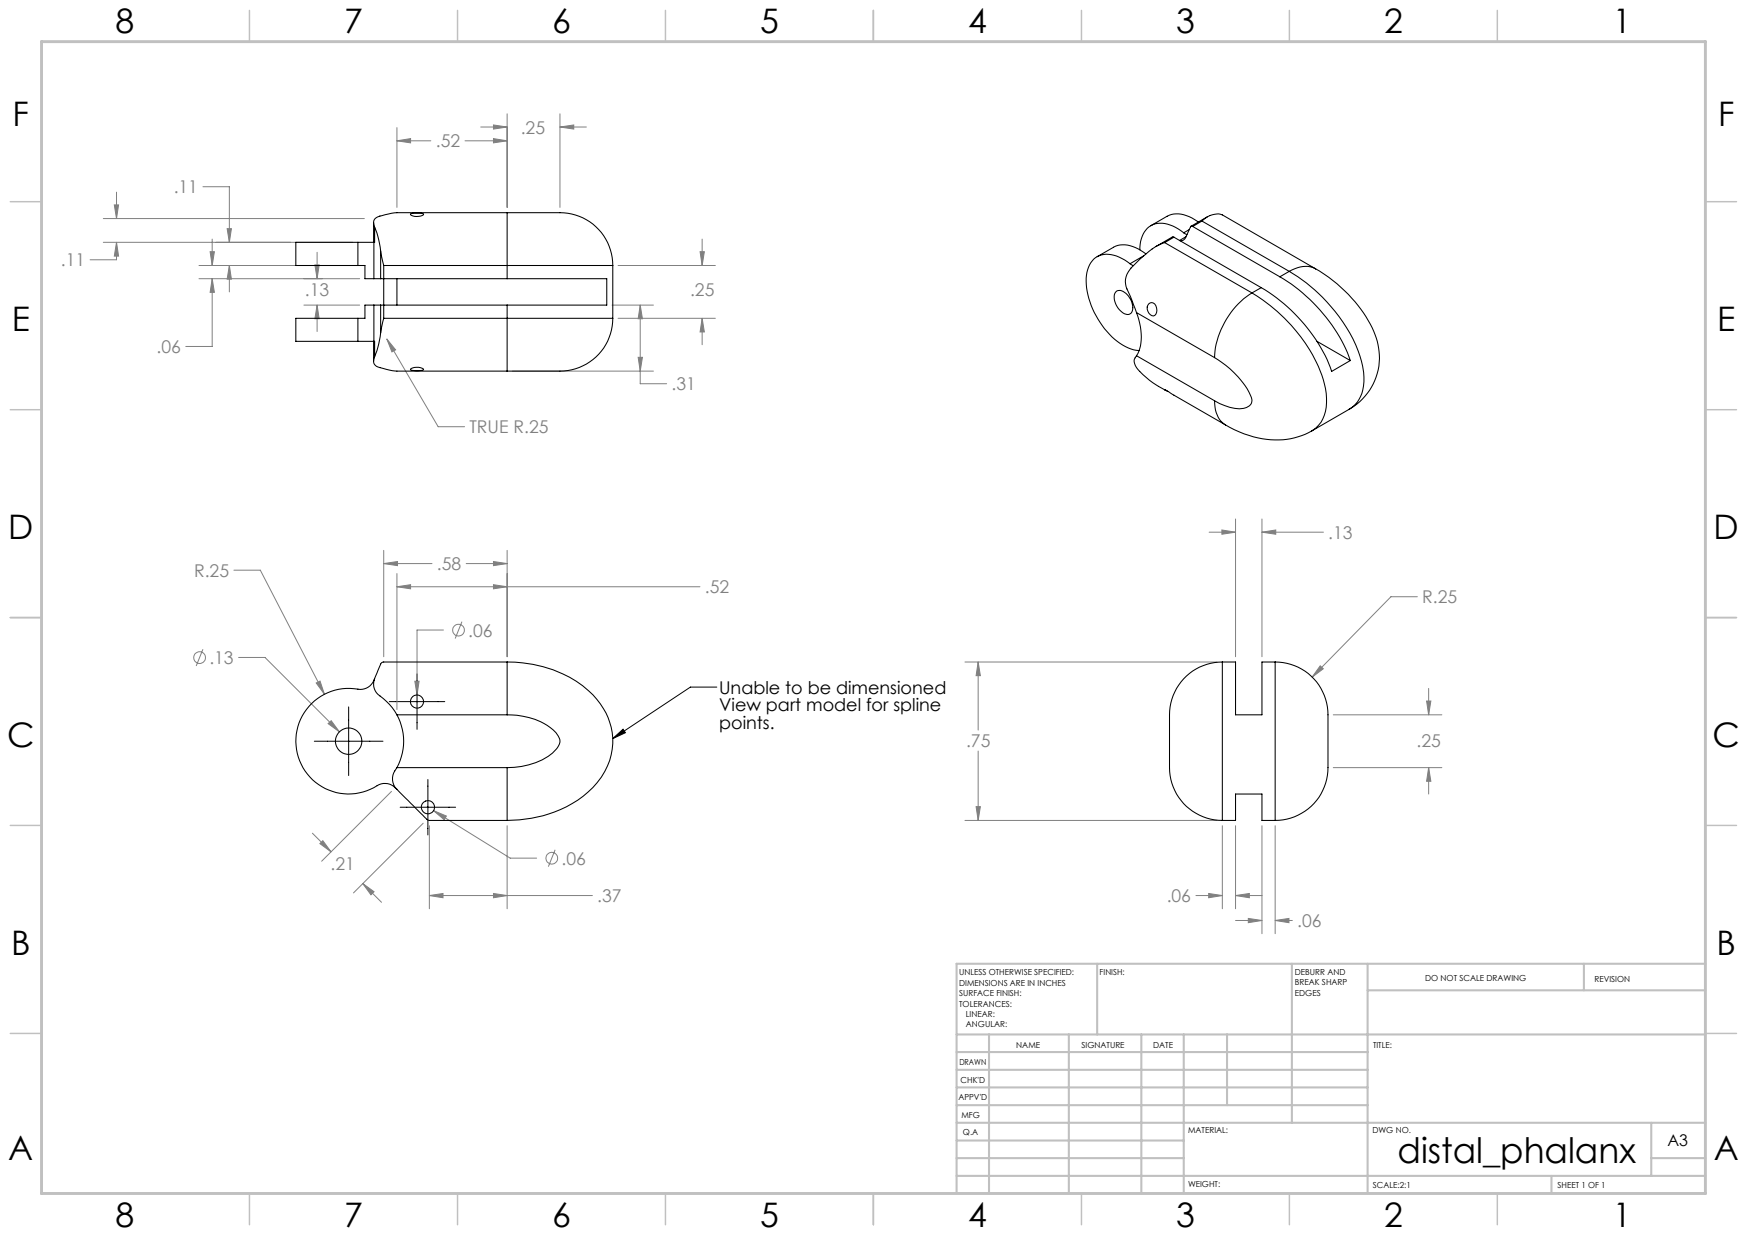
[picture p49: page 1]
TRUE R.25; FINISH:; DEBURR AND; BREAK SHARP; DO NOT SCALE DRAWING; REVISION; SCALE:2:1; SHEET 1 OF 1

Unable to be dimensioned
View part model for spline
points.

UNLESS OTHERWISE SPECIFIED:
DIMENSIONS ARE IN INCHES
SURFACE FINISH:
TOLERANCES:
LINEAR:
ANGULAR:

NAME | SIGNATURE | DATE | | | | TITLE:

DRAWN
CHK'D
APPV'D
MFG
Q.A | | | | MATERIAL: | DWG NO. distal_phalanx | A3
