Biological-Robotics-at-Tulsa/The-TU-Hand/Drawings/Metacarpal Distal - TU Hand 2019 v1.PDF

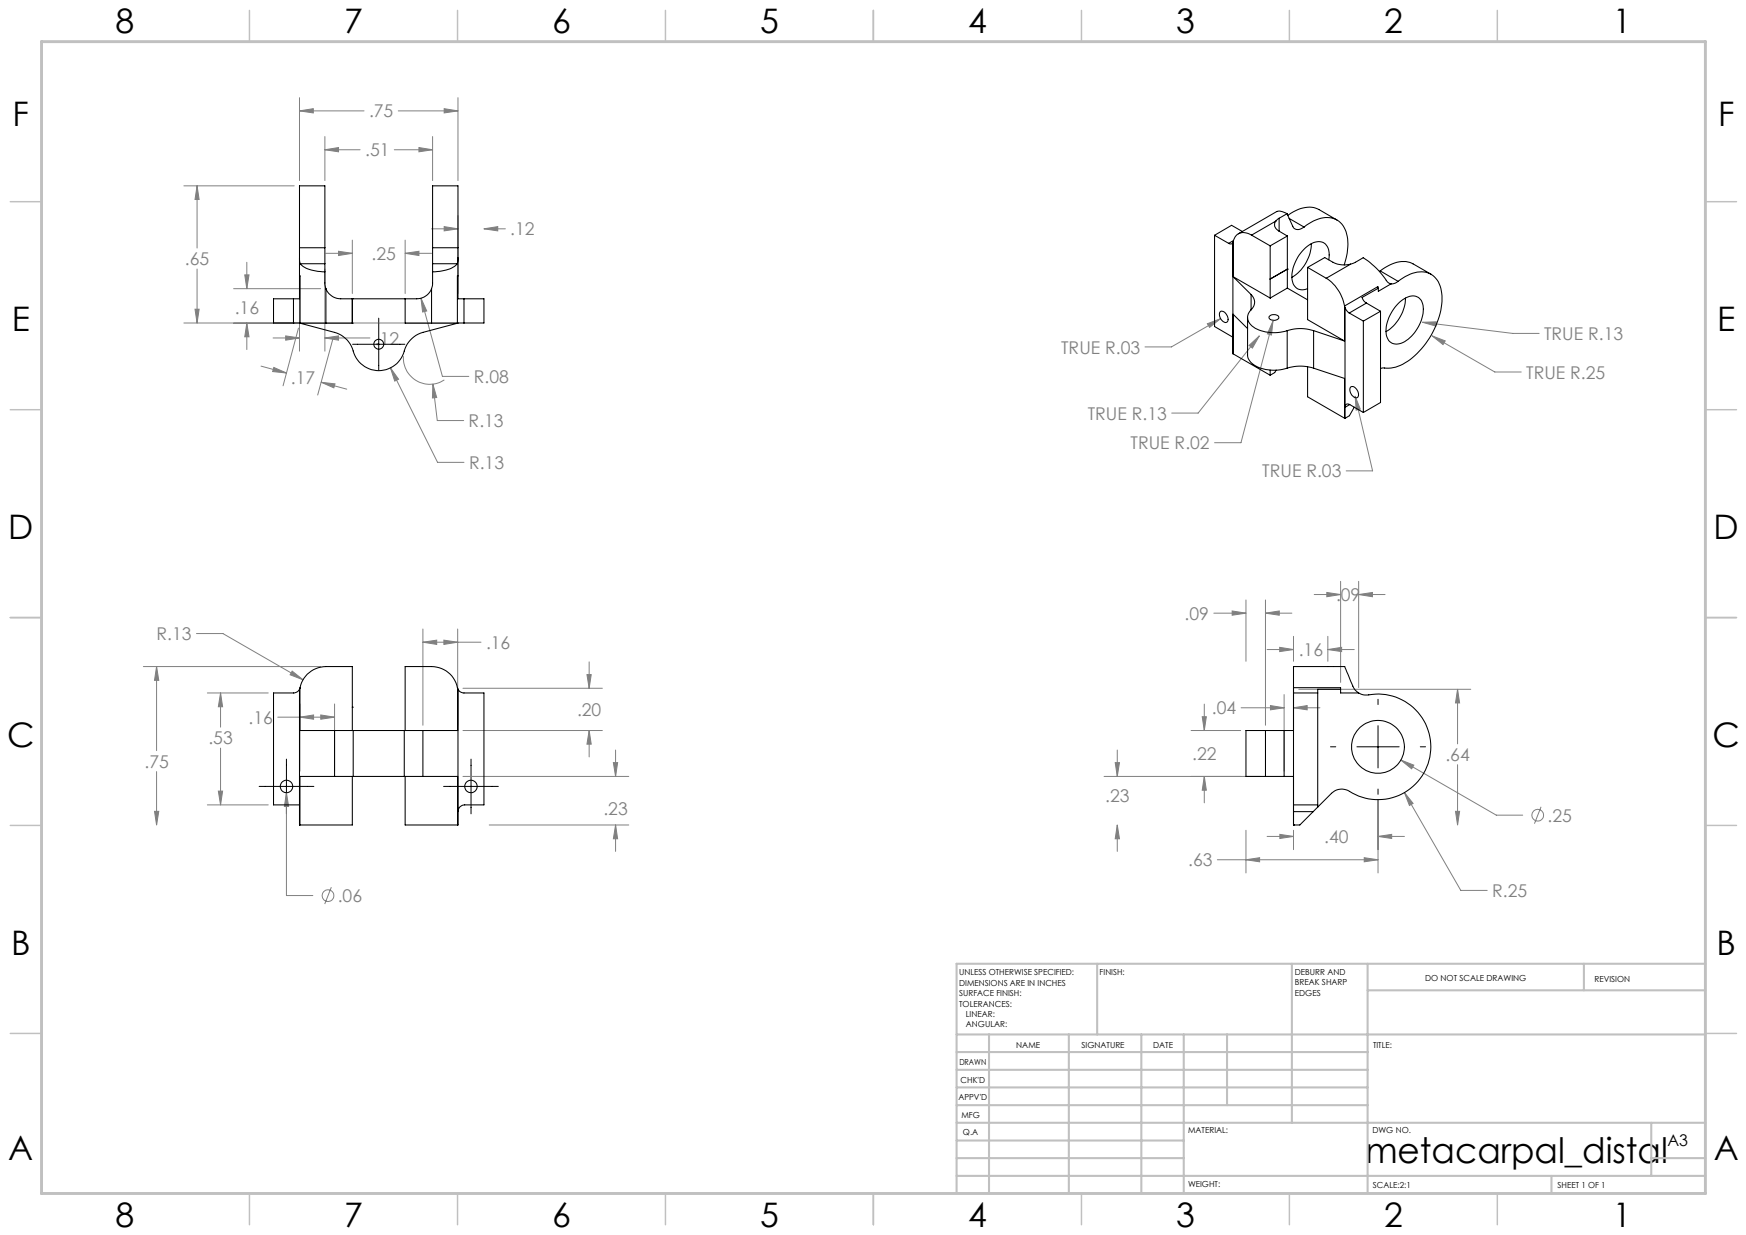
[picture p50: page 1]
TRUE R.13; TRUE R.03; TRUE R.02; TRUE R.25; FINISH:; DEBURR AND; BREAK SHARP; DO NOT SCALE DRAWING; REVISION; SCALE:2:1; SHEET 1 OF 1

UNLESS OTHERWISE SPECIFIED:
DIMENSIONS ARE IN INCHES
SURFACE FINISH:
TOLERANCES:
LINEAR:
ANGULAR:

NAME | SIGNATURE | DATE | | | | TITLE:

DRAWN
CHK'D
APPV'D
MFG
Q.A | | | | MATERIAL: | DWG NO. metacarpal_distal | A3
