Biological-Robotics-at-Tulsa/The-TU-Hand/Drawings/Fusion 360/Thumb Drawings/Aluminum Bar x4 - TU Hand 2019 Drawing v2.pdf

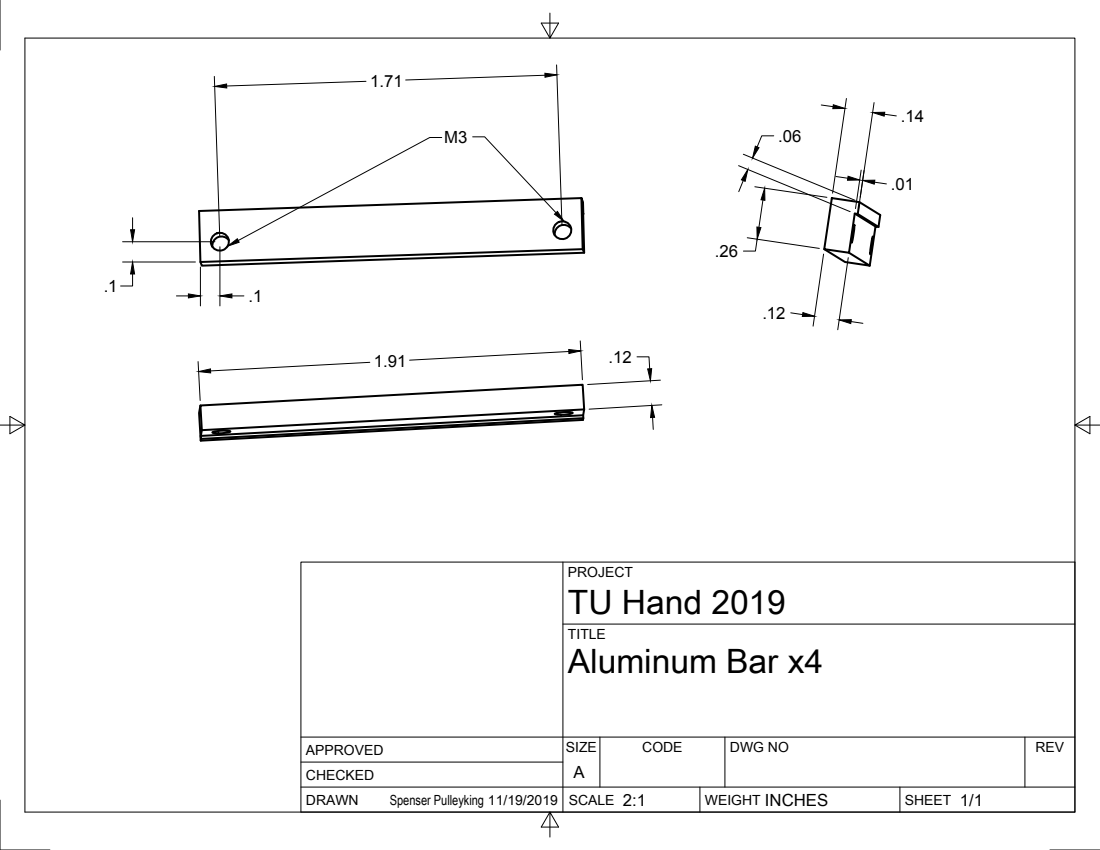
[picture p52: page 1]
SIZE; CODE; DWG NO; REV; Spenser Pulleyking 11/19/2019; INCHES; TU Hand 2019; Aluminum Bar x4
