Biological-Robotics-at-Tulsa/The-TU-Hand/Drawings/Fusion 360/Thumb Drawings/Aluminum Delrin Thumb Fusion Phalange - TU Hand 2019 Drawing v1.pdf

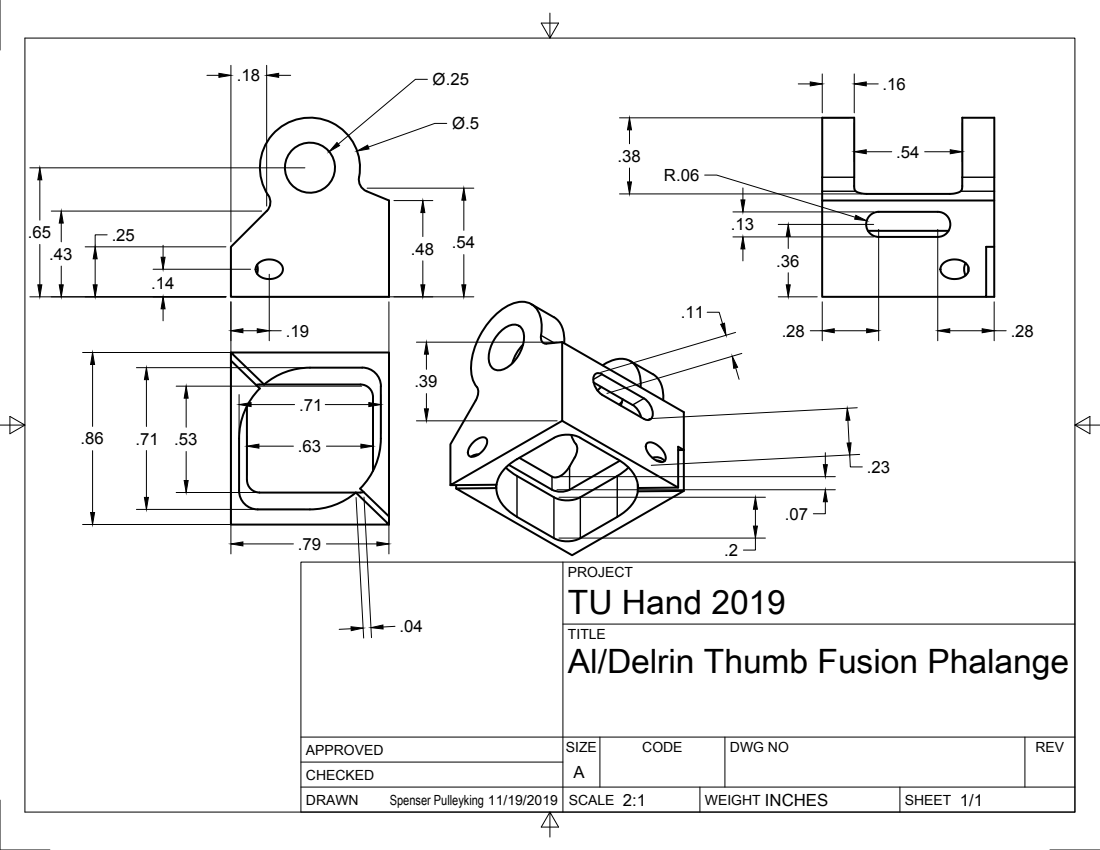
[picture p53: page 1]
SIZE; CODE; DWG NO; REV; Spenser Pulleyking 11/19/2019; INCHES

PROJECT
TU Hand 2019
Al/Delrin Thumb Fusion Phalange
