Biological-Robotics-at-Tulsa/The-TU-Hand/Drawings/Fusion 360/Thumb Drawings/Brass Torches x4 - TU Hand 2019 Drawing v1.pdf

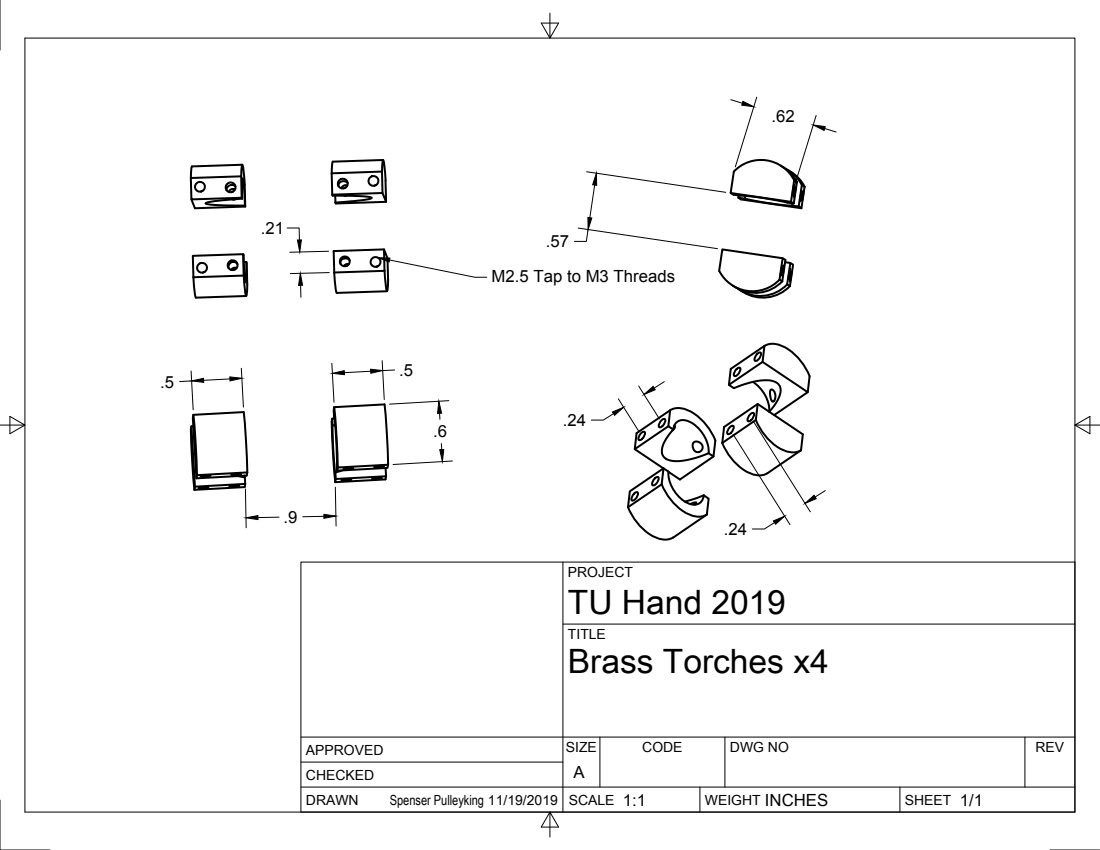
[picture p54: page 1]
SIZE; CODE; DWG NO; REV; Spenser Pulleyking 11/19/2019; INCHES; TU Hand 2019; Brass Torches x4

M2.5 Tap to M3 Threads
