Biological-Robotics-at-Tulsa/The-TU-Hand/Drawings/Fusion 360/Thumb Drawings/Gearbox Replacement - TU Hand 2019 Drawing v1.pdf

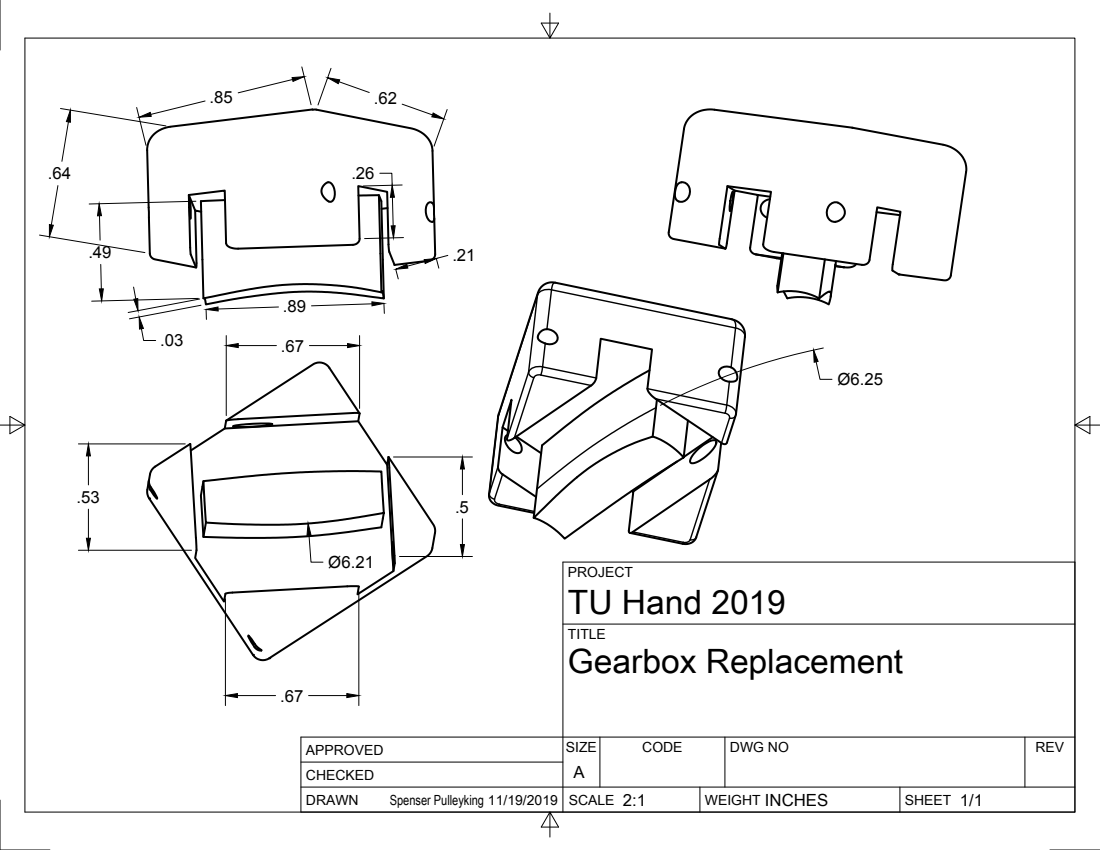
[picture p56: page 1]
SIZE; CODE; DWG NO; REV; Spenser Pulleyking 11/19/2019; INCHES; TU Hand 2019; Gearbox Replacement
