Biological-Robotics-at-Tulsa/The-TU-Hand/Drawings/Fusion 360/Thumb Drawings/Magnetic Ceramic Ellipsoids - TU Hand 2019 Drawing v2.pdf

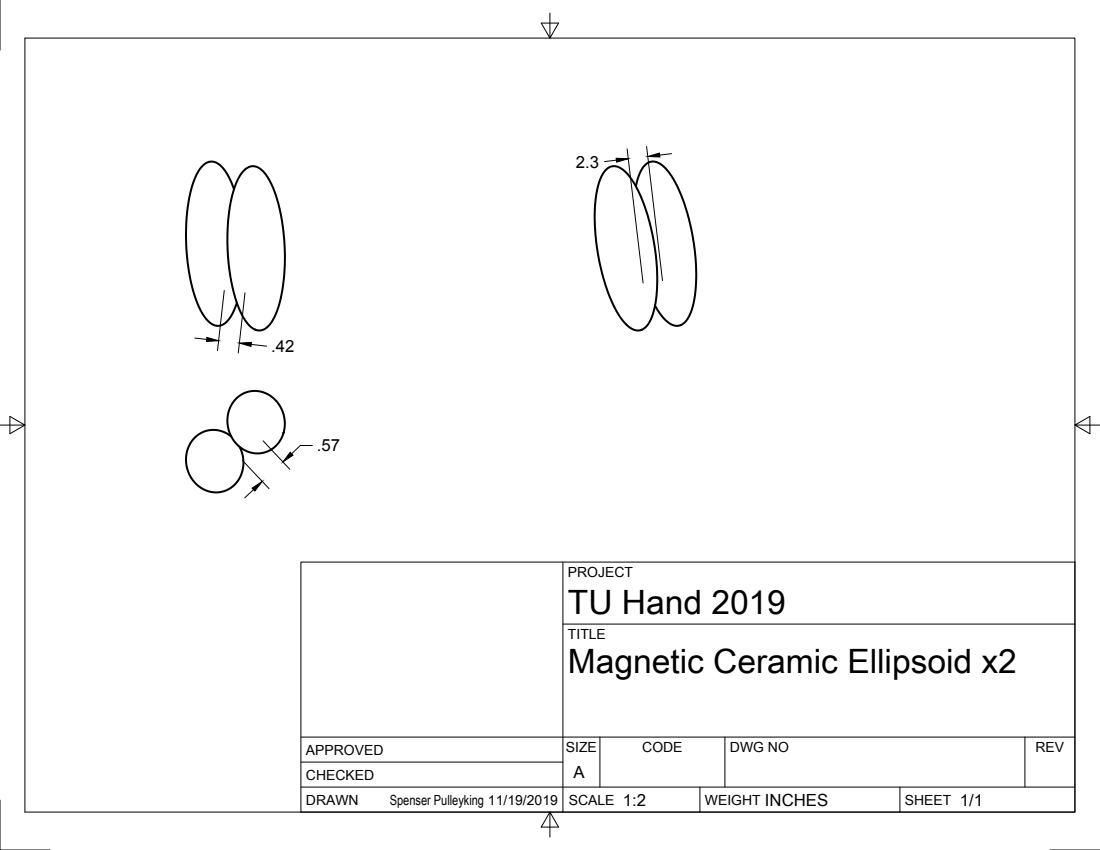
[picture p57: page 1]
SIZE; CODE; DWG NO; REV; Spenser Pulleyking 11/19/2019; INCHES

PROJECT
TU Hand 2019
Magnetic Ceramic Ellipsoid x2
