Biological-Robotics-at-Tulsa/The-TU-Hand/Drawings/Fusion 360/Thumb Drawings/Polypropylene Flexure Hinge x2 - TU Hand 2019 Drawing v1.pdf

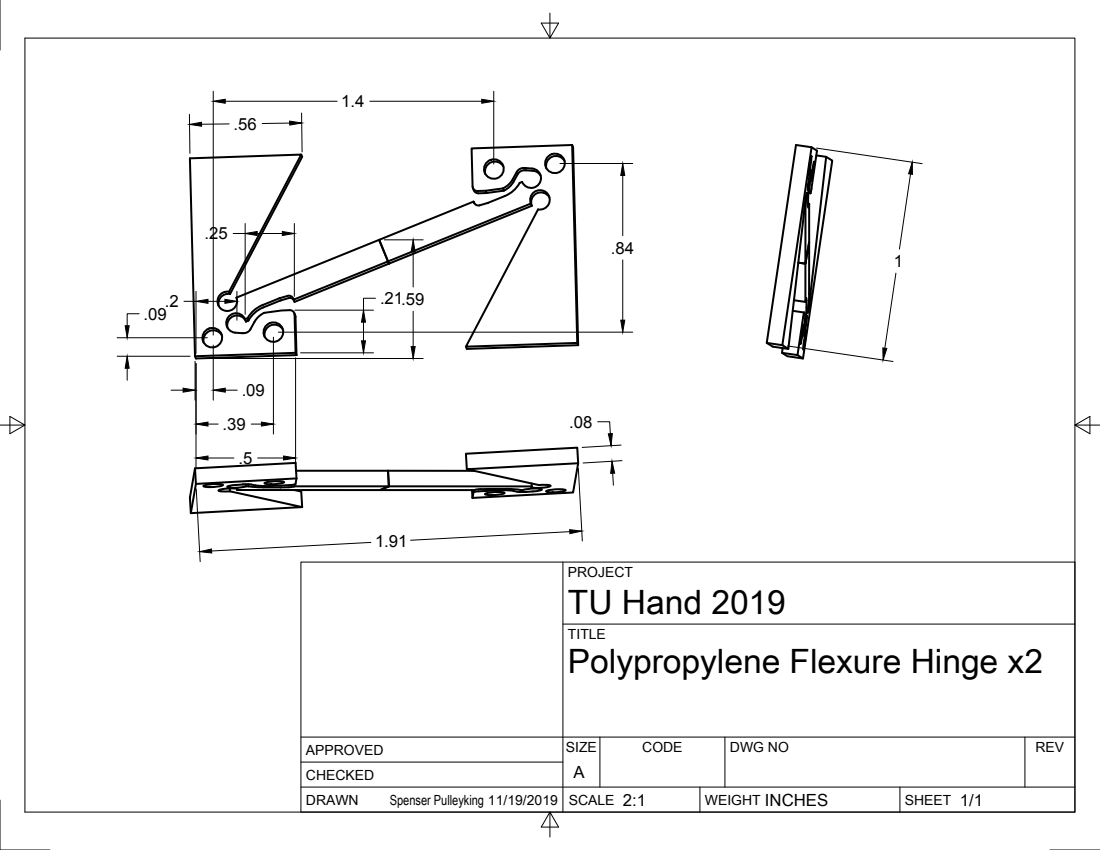
[picture p58: page 1]
SIZE; CODE; DWG NO; REV; Spenser Pulleyking 11/19/2019; INCHES

PROJECT
TU Hand 2019
Polypropylene Flexure Hinge x2
