Biological-Robotics-at-Tulsa/The-TU-Hand/Drawings/Fusion 360/Thumb Drawings/Tendon Routing System - TU Hand 2019 Drawing v1.pdf

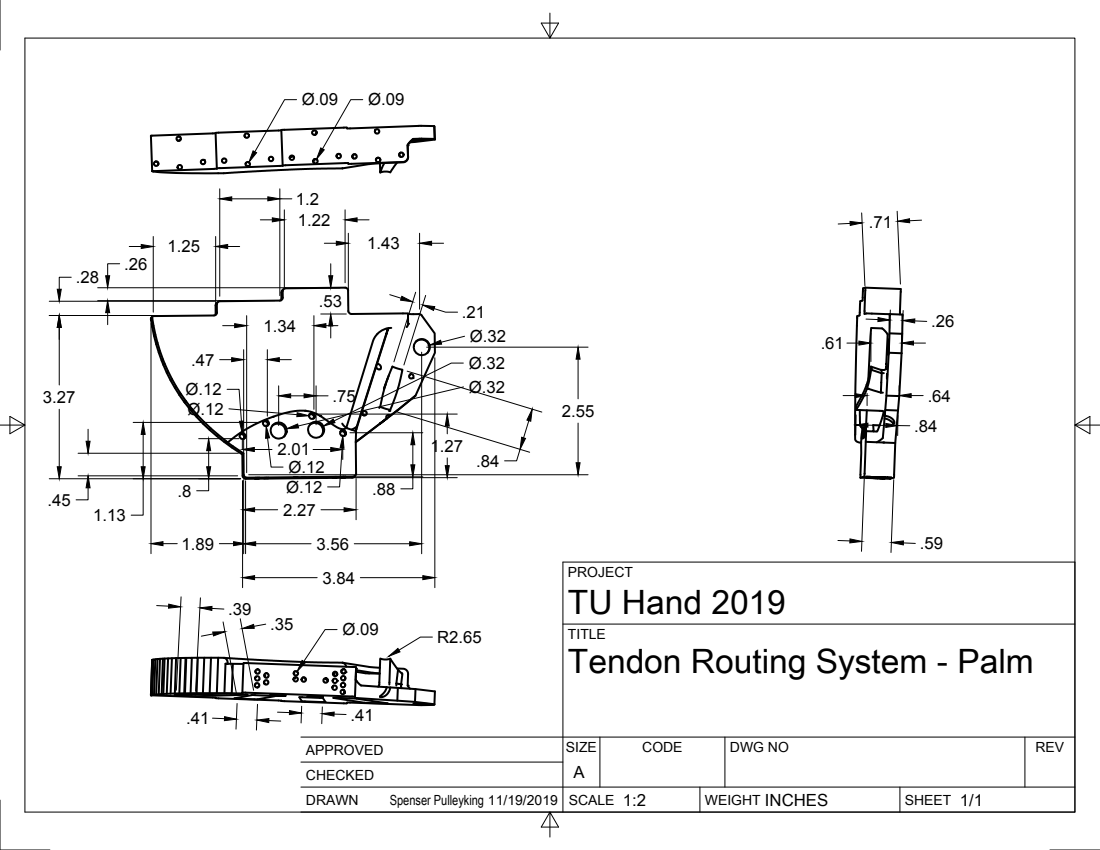
[picture p59: page 1]
SIZE; CODE; DWG NO; REV; Spenser Pulleyking 11/19/2019; INCHES

TU Hand 2019
Tendon Routing System - Palm
