Biological-Robotics-at-Tulsa/The-TU-Hand/Drawings/Fusion 360/Thumb Drawings/Thumb Distal Phalanx - TU Hand 2019 Drawing v1.pdf

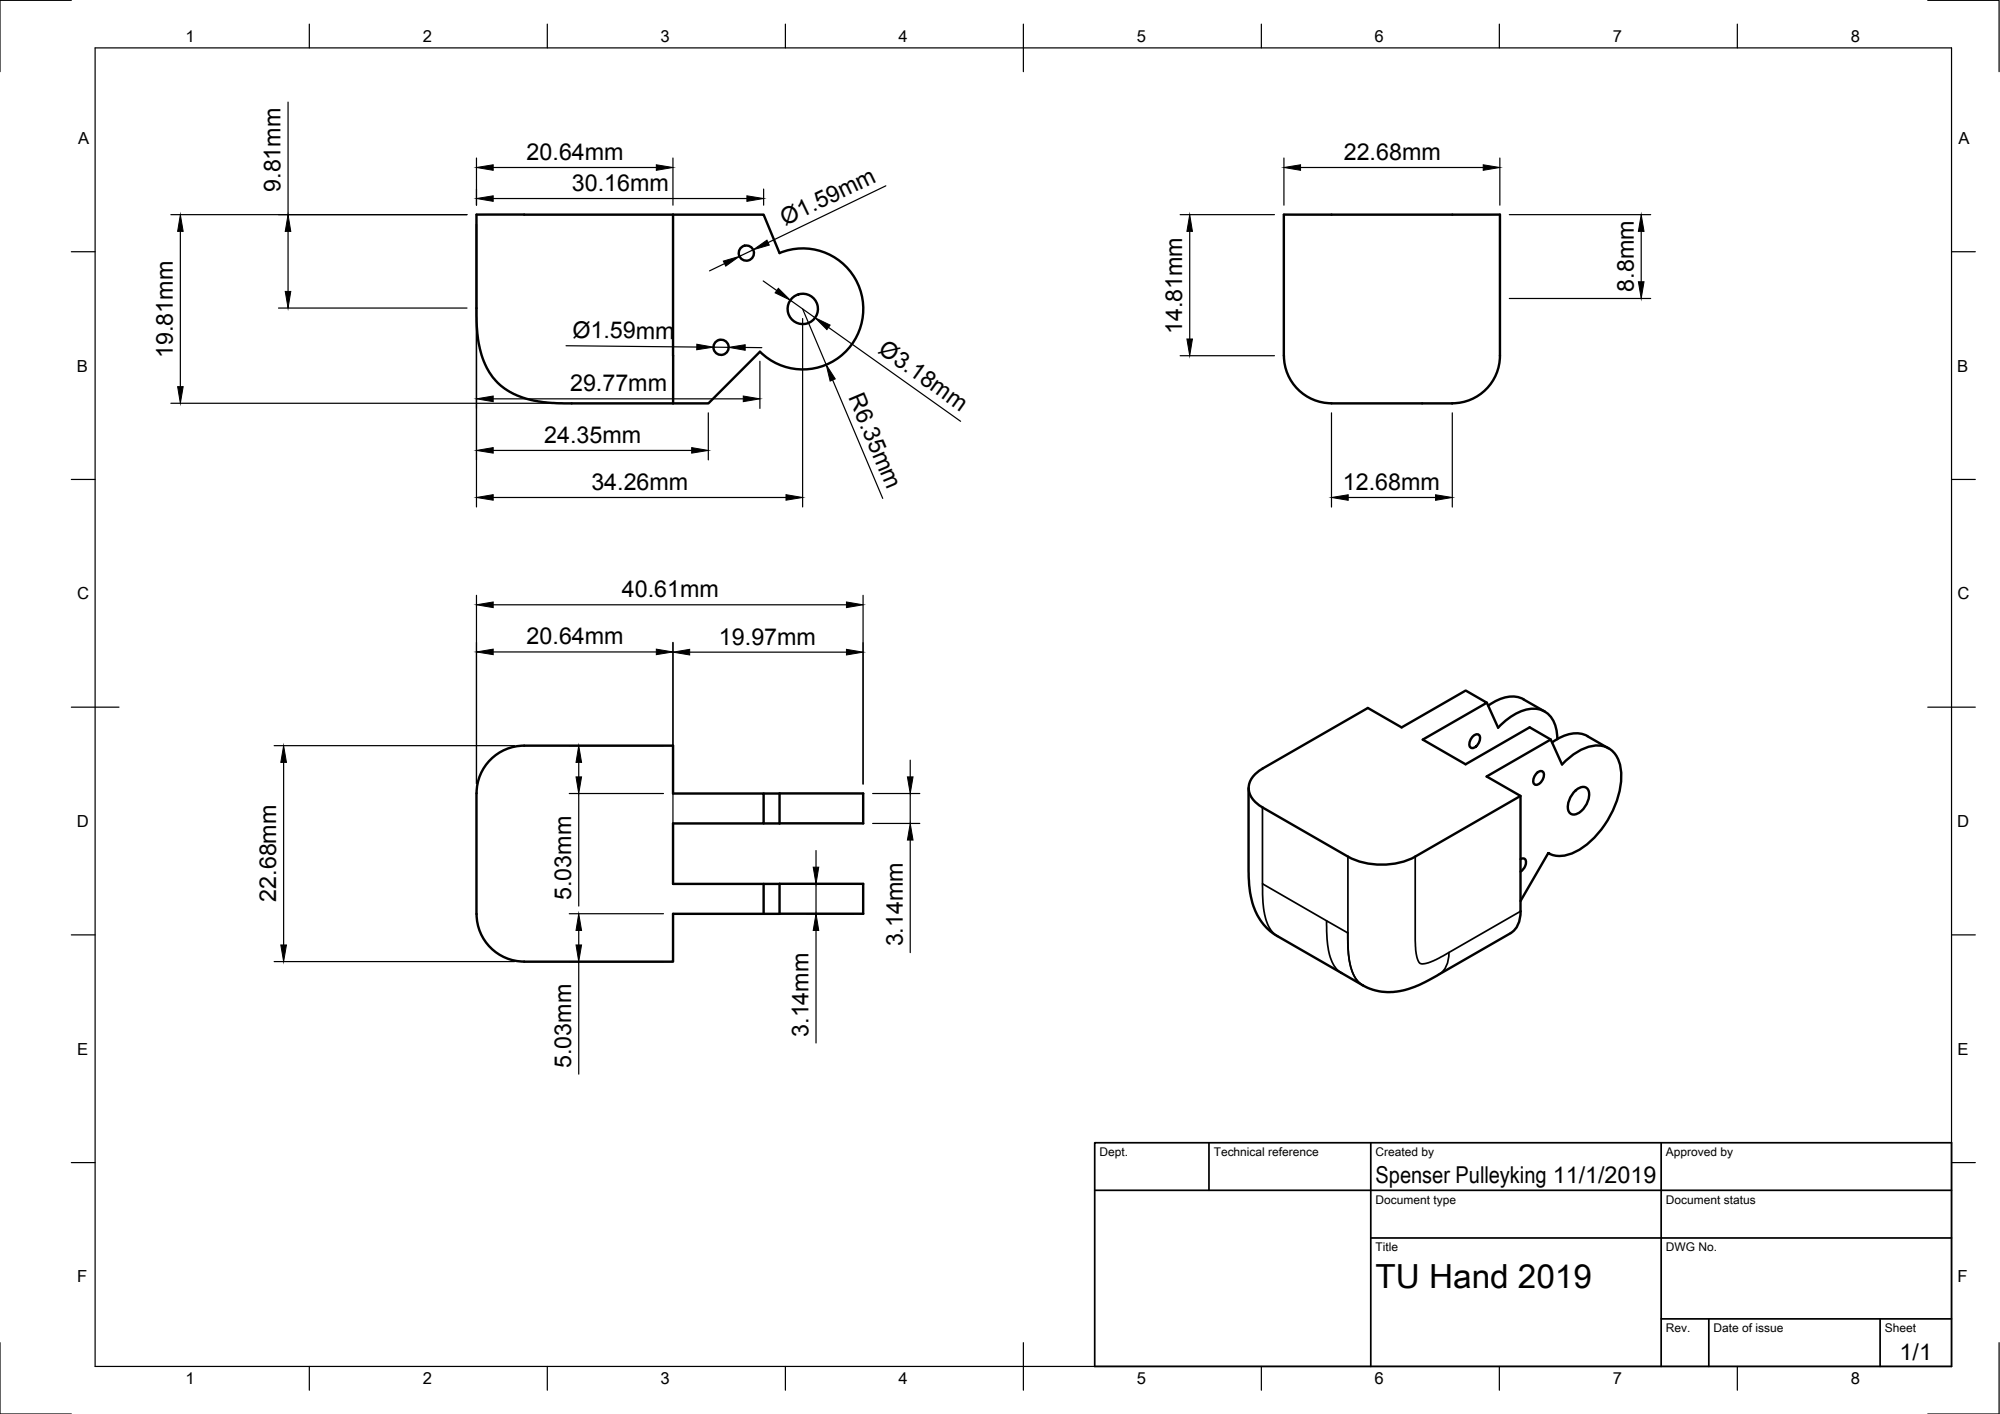
[picture p60: page 1]
Spenser Pulleyking 9.81mm 19.81mm

Dept. | Technical reference | Created by 11/1/2019 | Approved by

Document type | Document status

Title TU Hand 2019 | DWG No.

Rev. | Date of issue | Sheet 1/1
