Biological-Robotics-at-Tulsa/The-TU-Hand/Drawings/Fusion 360/Thumb Drawings/Thumb Distal Phalanx Bearing x2 - TU Hand 2019 Drawing v1.pdf

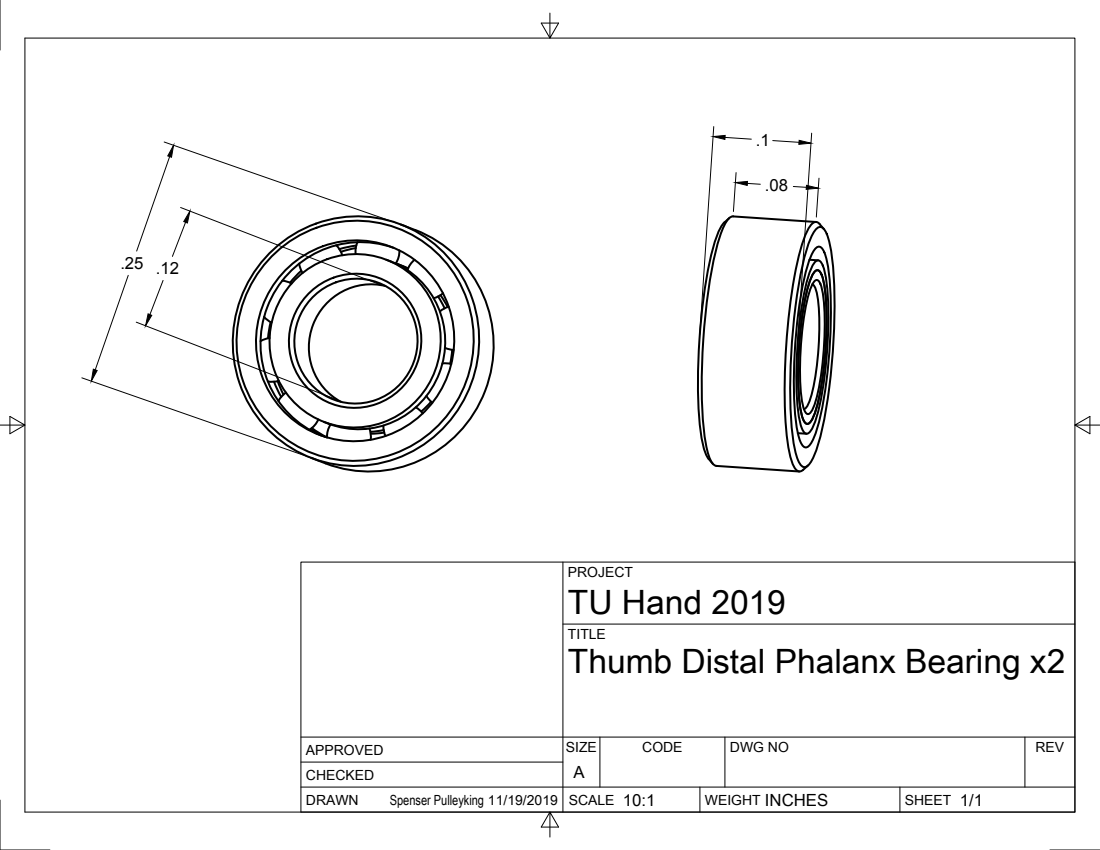
[picture p61: page 1]
SIZE; CODE; DWG NO; REV; Spenser Pulleyking 11/19/2019; INCHES

PROJECT
TU Hand 2019
Thumb Distal Phalanx Bearing x2
