Biological-Robotics-at-Tulsa/The-TU-Hand/Firmware/TU Hand 2019 Firmware/Thumb-BLDC-TivaC/BLDC_Bare_Minimum/BLDC_Bare_Minimum.ino

int oscPin = PB_4;    // oscilloscope connection


void setup() {
  // put your setup code here, to run once:
 analogWrite(oscPin, 30);  
}

void loop() {
  // put your main code here, to run repeatedly: 
 //   unsigned long currentMillis = millis();
// Serial.println(currentMillis);
//      analogWrite(oscPin, 254);         
//delay(3000);
}
