Biological-Robotics-at-Tulsa/The-TU-Hand/(commit log)

2019-10-30 updated index and file structure, added CAD
    [2016thumb_workspace.SLDPRT, 57155K346_SS BALL BEARING.SLDPRT, Tendon Subway System.SLDPRT, URDF_3434T210_PULLEY FOR WIRE ROPE.SLDPRT, URDF_57155K359_SS BALL BEARING.SLDPRT, URDF_6391K113_OIL-EMBEDDED SLEEVE BRNG.SLDPRT, URDF_90145A480_long_pin_(unhardened)_PULLEYHOLDER.SLDPRT, URDF_90145A480_long_pin_(unhardened)_SLIDER.SLDPRT]
2019-10-30 upload drawings and firmware
    [TU Hand 2018.DXF, TU Hand 2018_2.DXF]
2019-10-30 uploaded thumb bldc firmware
2019-10-30 uploaded BOM, How-to guides, and more firmware for wrist and DC motors
    [TU_Hand_BOM.xlsx]
2019-11-20 Palm and Finger Drawings updated
    [distal_phalanx.SLDDRW, metacarpal_distal.SLDDRW, metacarpal_proximal.SLDDRW, middle_phalanx.SLDDRW, nipun.SLDDRW, proximal_phalanx.SLDDRW]
2021-02-16 Wolfram Mathematica Finger Kinematics
    The Wolfram Mathematica files compute the tendon excursions for the fingers of the TU Hand given the angle of the DIP, PIP, and the flexion/extension and abduction/adduction angles of the MCP. There are two files, one for when the lateral bands pass over the mechanical stop dorsally, and the other when they pass on the volar side. Both call extraFunctions.m and Function_to_Determine_Points_of_Tangency.m in order to run. See Schultz and Rake "A four-tendon robotic
    finger with tendon transmission inspired by the human extensor mechanism" in Bioinspiration and Biomimetics, for more info. Please cite this paper if the code is used.
2021-02-16 Create Finger-Kinematics
    Folder that holds Kinematic models of the fingers (pose-tendon relationships).
2021-02-16 Kinematic Models of the Finger
    Wolfram Mathematica files that compute the tendon excursions of the flexor, extensor, and radial and ulnar interossei tendons given the pose of the finger (DIP and PIP angles, and the flexion-extension and abduction-adduction angles of the MCP). extraFunctions.m and Function_to_Determine_Points_of_Tangency.m are called by the .nb files. One of these files computes the excursions when the lateral bands are routed dorsal to the mechanical stop, the other when the excursions are routed volar to the mechanical stop. For more information, see Schultz and Rake, "A four-tendon robotic
    nger with tendon transmission inspired by the human extensor mechanism" in Bioinspi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
2021-03-03 Added via upload: torsional actuator - Dipayan Das
2021-07-06 Uploaded newer CAD of TU Hand.
2025-08-05 Add TU Hand URDF Gazebo simulation packages
    Introduce two new ROS packages for TU Hand simulation: TU_Hand_URDF and postfinal_TUHand. Each package includes CMake and package configuration, launch files for Gazebo and RViz, joint configuration YAMLs, STL mesh files for all hand links, and URDF robot descriptions. These additions enable full simulation and visualization of the TU Hand in Gazebo and RViz. - (Github-AI Generated Description)
    [TU_Hand_2.urdf, base_link.STL, i_dp_link.STL, i_middle_link.STL, i_proximal_link.STL, i_trans_link.STL, index_dp_flex.STL, index_mcp_flex.STL]
2025-09-04 Reformat folder: Robotic Operating System
    Replaced Gazebo URDF simulation with Robotic Operating System; sub-folder structure update pulled in from personal repo latest commit (TU_Hand_URDF).
    [Monday_export_run1_go.urdf, TUHand.urdf, TU_Hand_2.urdf, base_link.STL, i_dp_link.STL, i_middle_link.STL, i_proximal_link.STL, i_trans_link.STL]
2025-09-04 updated README
    updated README to reflect that URDF viewing method works in any modern browser.
2025-09-04 add example.png, rename parent folder
    Improved folder names to avoid ambiguity, added example.png
    [Monday_export_run1_go.urdf, TUHand.urdf, TU_Hand_2.urdf, base_link.STL, i_dp_link.STL, i_middle_link.STL, i_proximal_link.STL, i_trans_link.STL]
